Munir-Altaher/leg-day/sim/runs/parts_colour.png

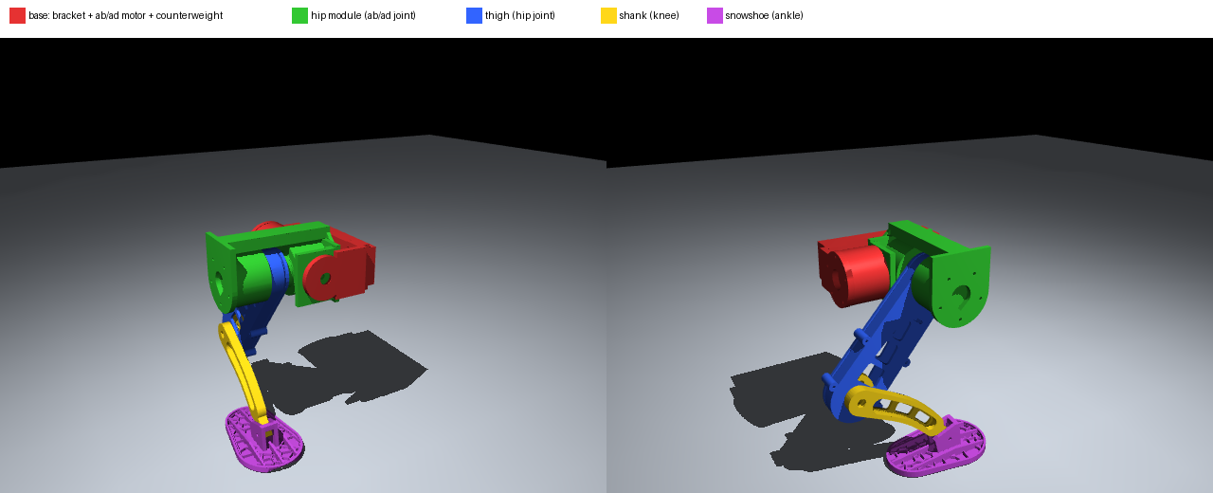
sim/runs/parts_colour.png
