Munir-Altaher/leg-day/reference/IMG_4815.jpeg

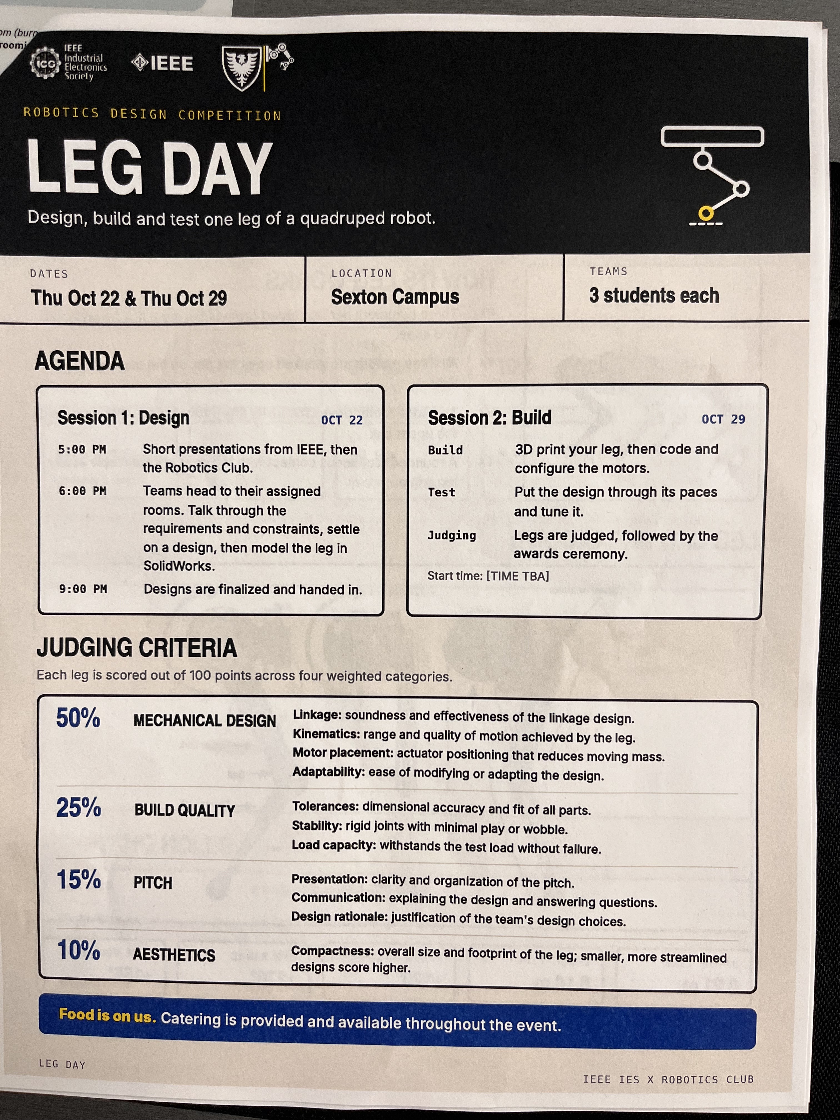
reference/IMG_4815.jpeg
