Munir-Altaher/leg-day/analysis/out/report.md

# Leg analysis report (generated by analysis/leg_model.py)

- FK->IK round trip over joint ranges: worst error 3.12e-13 deg -> PASS
- Belt-coupling virtual-work check (tau_q = A^T tau_m, th_k = q1 + N q2): PASS

## Sanity anchors (brief 4.4, 4.5)

| knee pulley | N | max vertical F (belt 120 N, rated torque) |
|---|---|---|
| 20T | 1.0 | 8.3 N |
| 40T | 2.0 | 16.6 N |
| 48T | 2.4 | 19.9 N |
| 60T | 3.0 | 24.9 N |

Ab/ad, l=40 mm, 20 N vertical: |tau0| = 0.80 Nm; with +/-2 N lateral: 0.43 / 1.17 Nm

## Design point: L1 = L2 = 130 mm, 20T:60T (N = 3.00), l = 53.0 mm

Nominal stance height STANCE_FRAC(L1+L2) = 213 mm

- Nominal stance joint angles: q1 = -34.9 deg, q2 = 69.8 deg
- Continuous capability (+/-10% lateral, motors <= rated, belt <= 60 N): **15.4 N** vertical (target >= 15 N)
- Peak capability (motors <= peak, belt <= 120 N): **30.8 N** vertical

Static load case: 15 N down + 1.5 N lateral at nominal stance
- joint torques tau_q = [0.475, 0.000, -1.116] Nm
- motor torques [abad, hip, knee] = [0.475, 0.372, -0.372] Nm (rated 1.3)
- belt effective tension = 58.4 N (continuous limit 60 N)

## Firmware limits

- knee motor torque limit = T_peak x r_hip = 120 N x 6.37 mm = **0.76 Nm**
- hip motor: 4.1 Nm peak, set 2.5 Nm (structure SF>=2, see skeleton check); ab/ad: 2.5 Nm
- knee joint torque available at belt peak: 2.29 Nm

## Belt

- open-belt length at C = 130 mm: 341.2 mm -> 342 mm (171 teeth) + idler take-up; with 2 x 15 mm clamp overlap cut 372 mm (supplied 450 mm ASSUMED)
- preload >= 60 N per span (half of peak effective tension)
- 20T hip pulley wrap ~180 deg -> ~10 teeth in mesh; idler adds wrap

## Sweep: max continuous vertical force at nominal stance (+/-10% lateral, belt 60 N, rated torque)

| L (mm) | 40T | 48T | 60T | 48T, 24T hip (N=2) | 60T, 30T hip (N=2) |
|---|---|---|---|---|---|
| 110 | 12.1 | 14.6 | 18.2 | 14.6 | 18.2 |
| 120 | 11.1 | 13.3 | 16.7 | 13.3 | 16.7 |
| 130 | 10.3 | 12.3 | 15.4 | 12.3 | 15.4 |
| 140 | 9.5 | 11.4 | 14.3 | 11.4 | 14.3 |
| 150 | 8.9 | 10.7 | 13.3 | 10.7 | 13.3 |
| 160 | 8.3 | 10.0 | 12.5 | 10.0 | 12.5 |

Belt tension depends only on the knee pulley radius; a bigger hip pulley adds teeth in mesh but lowers N.

## Ab/ad torque vs l (15 N vertical + 1.5 N lateral, nominal stance)

- l = 40 mm: |tau_abad| = 0.28 Nm
- l = 52 mm: |tau_abad| = 0.46 Nm
- l = 60 mm: |tau_abad| = 0.58 Nm
- l = 80 mm: |tau_abad| = 0.88 Nm

## Speed

- hip joint max 38.7 rad/s; knee joint (motor / N) 12.9 rad/s (rated speed)
- swing +/-60 mm in 0.2 s: I_hip ~ 22.1 kg cm^2 (extended), alpha = 55 rad/s^2, hip torque ~ 0.24 Nm
- same leg with the knee motor at the knee: I_hip ~ 53.4 kg cm^2 (2.4x)
- reflected rotor inertia: hip/abad 54 kg cm^2, knee 486 kg cm^2 (catalog 540 g cm^2 â€” if that is already output-side, divide by 100; VERIFY)
