Munir-Altaher/leg-day/analysis/out/workspace_force_side.png

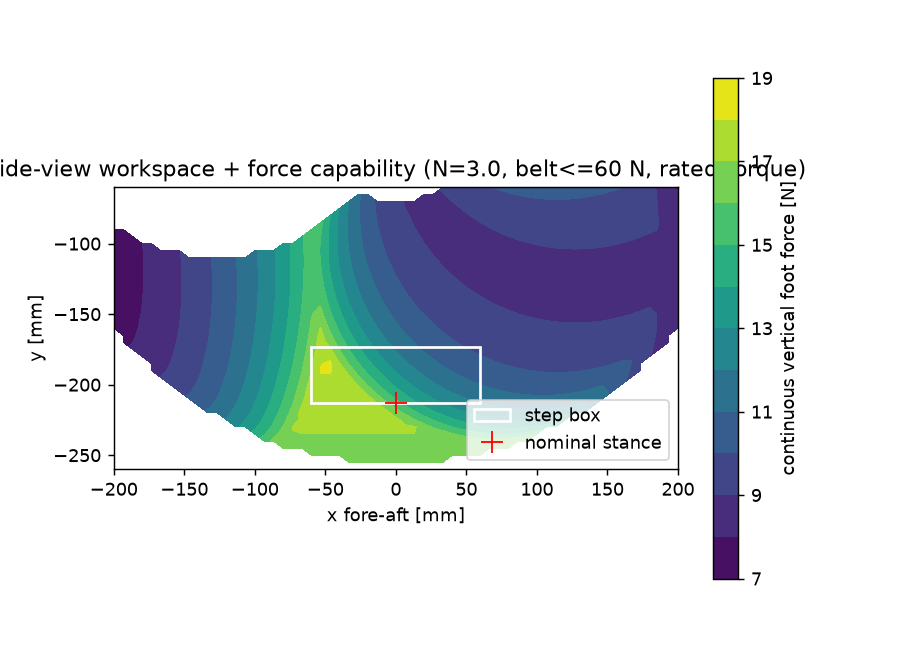
analysis/out/workspace_force_side.png
