Munir-Altaher/leg-day/analysis/out/workspace_front.png

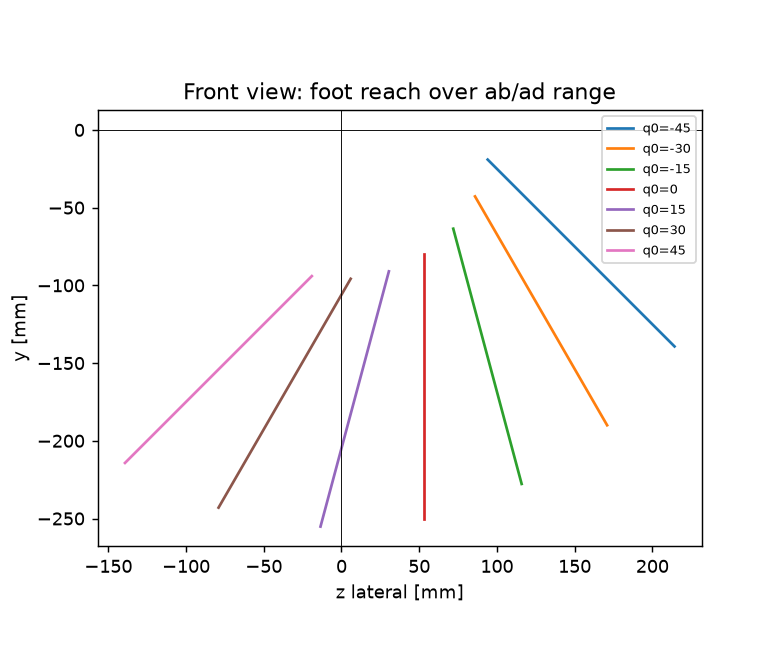
analysis/out/workspace_front.png
