Munir-Altaher/leg-day/docs/renders/bend_preview.png

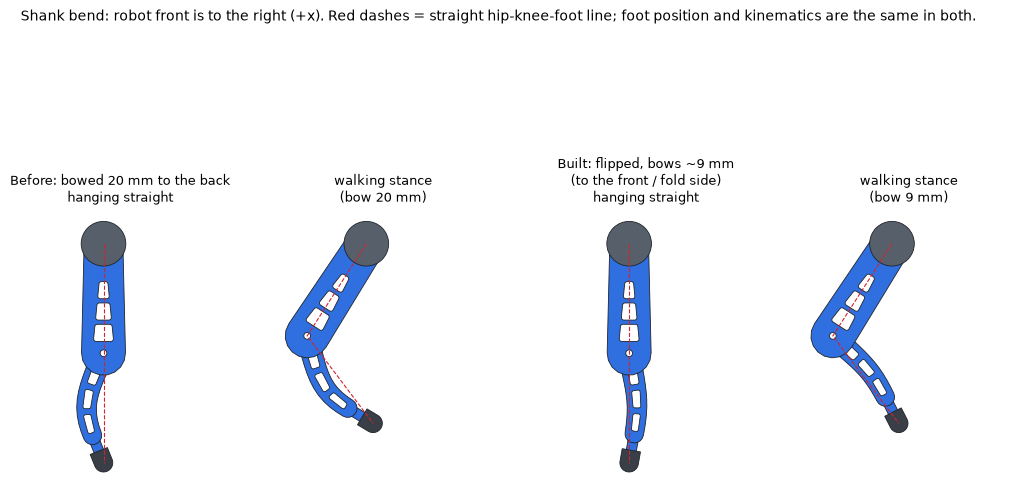
docs/renders/bend_preview.png
