Munir-Altaher/leg-day/docs/renders/cutout_final.png

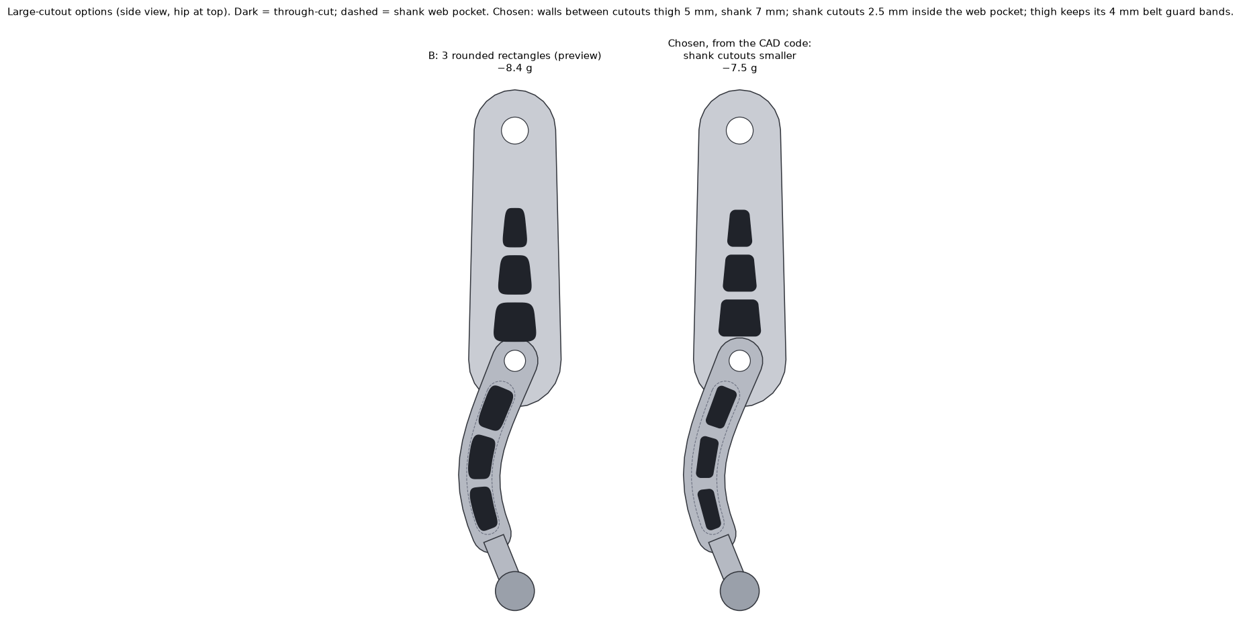
docs/renders/cutout_final.png
