Munir-Altaher/leg-day/docs/renders/cutout_options.png

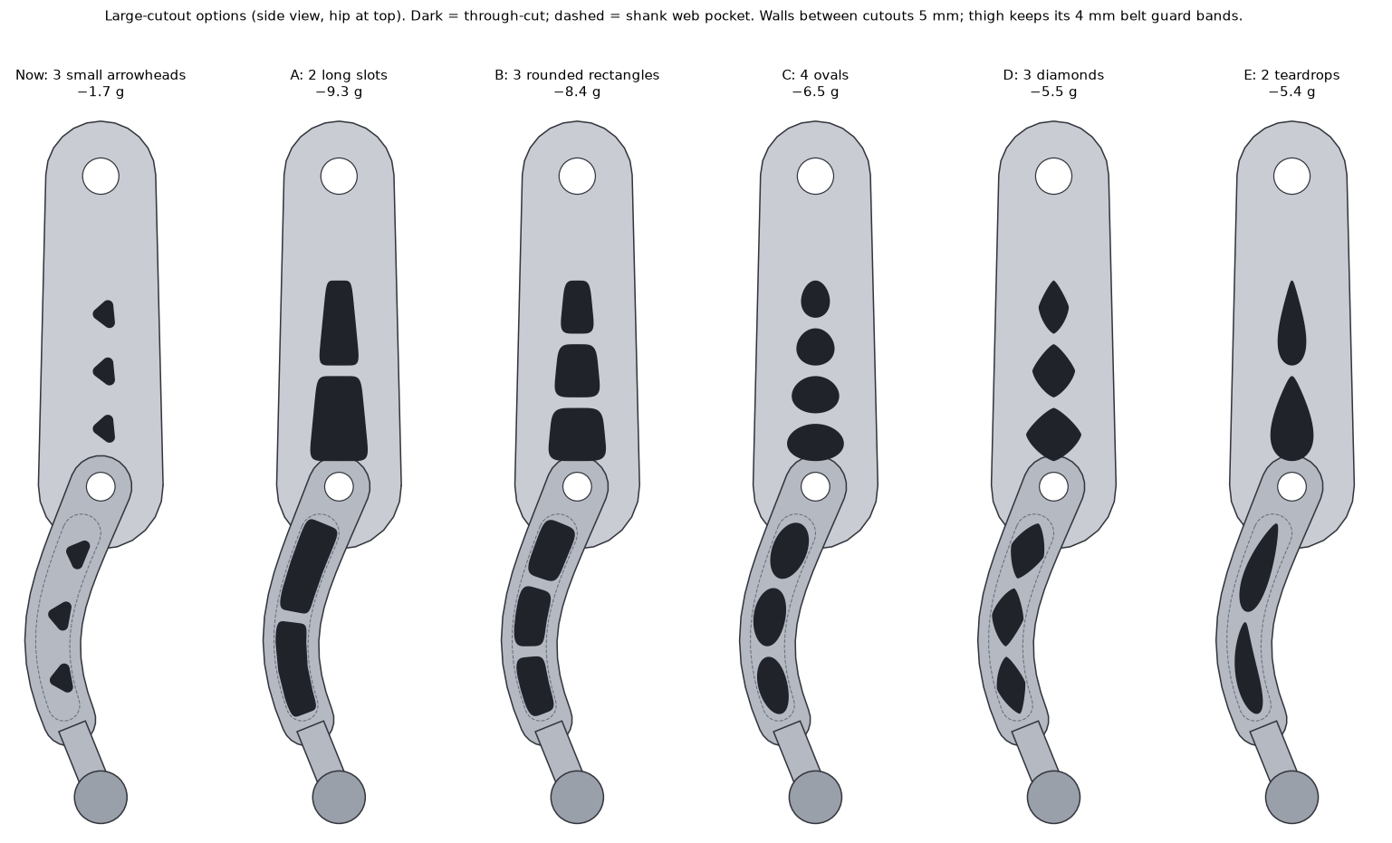
docs/renders/cutout_options.png
