Munir-Altaher/leg-day/docs/renders/cutout_options_triangles.png

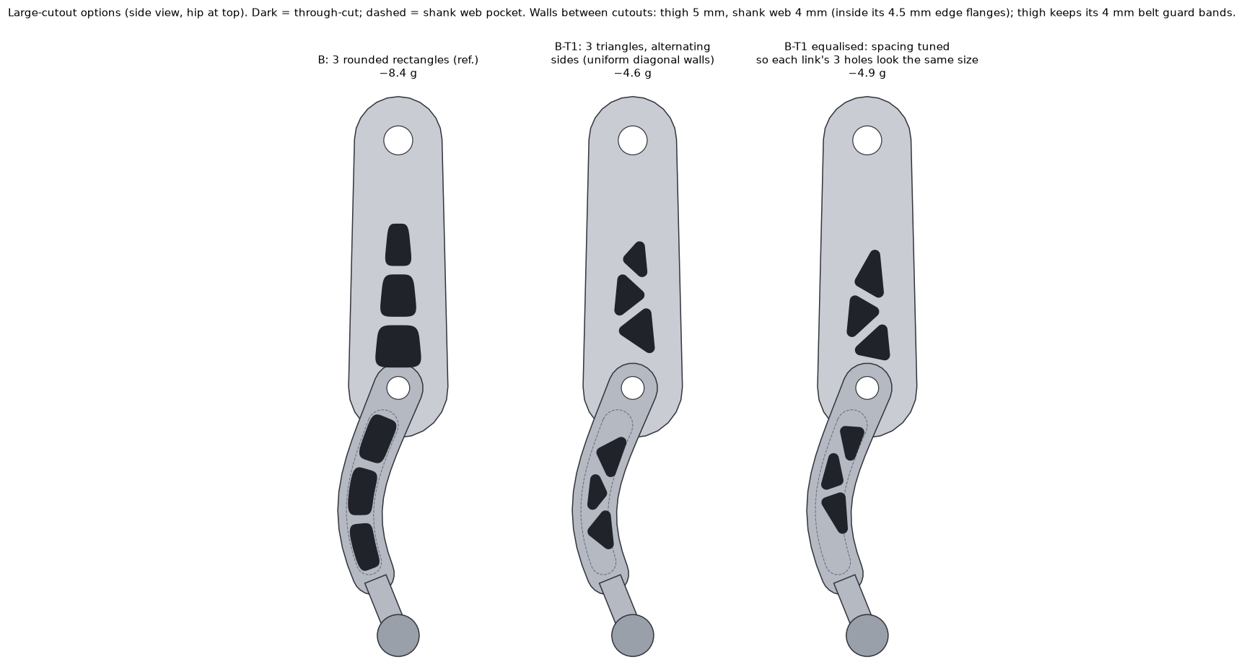
docs/renders/cutout_options_triangles.png
