Munir-Altaher/leg-day/docs/renders/leg_3dof_front.png

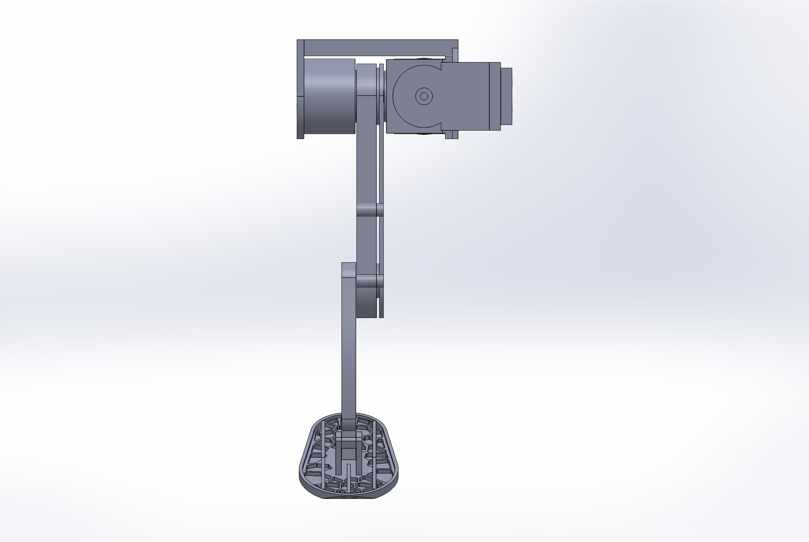
docs/renders/leg_3dof_front.png
