Munir-Altaher/leg-day/docs/renders/leg_3dof_iso.png

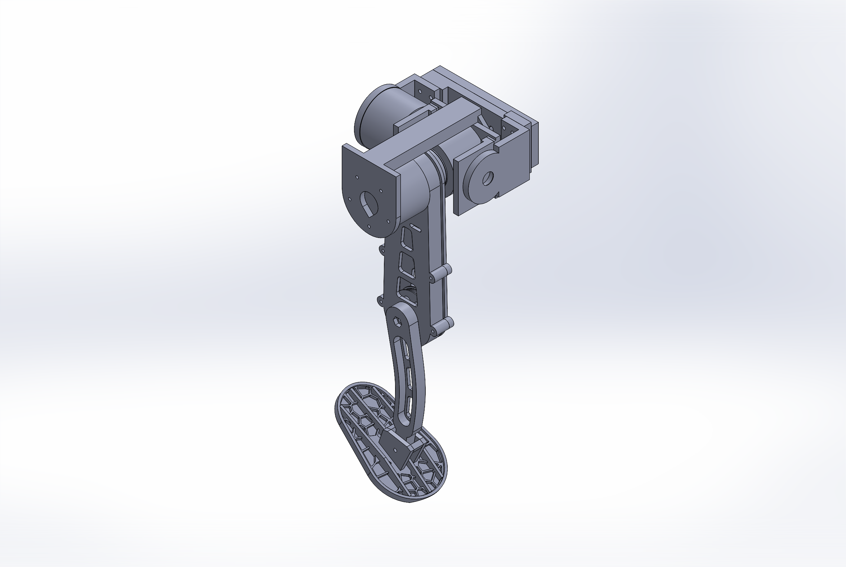
docs/renders/leg_3dof_iso.png
