Munir-Altaher/leg-day/docs/renders/leg_3dof_side.png

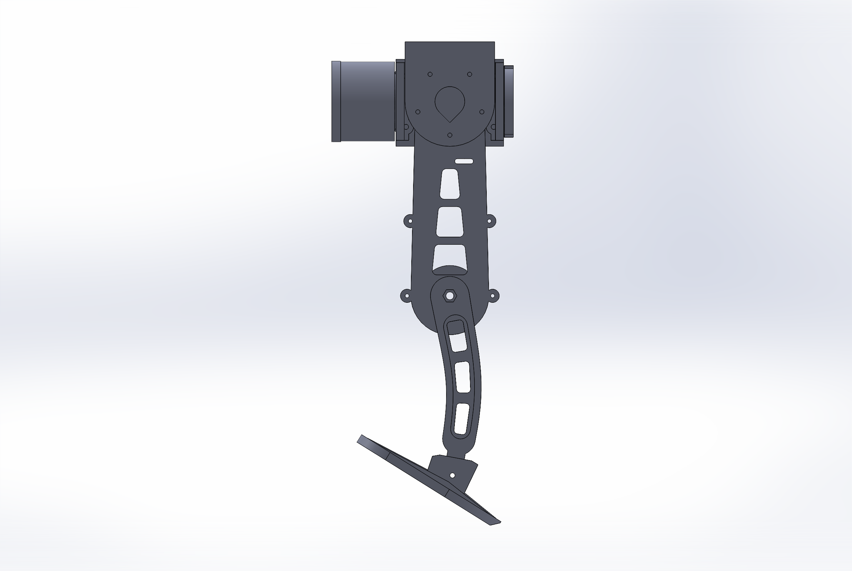
docs/renders/leg_3dof_side.png
