Munir-Altaher/leg-day/docs/renders/leg_3dof_side_outboard.png

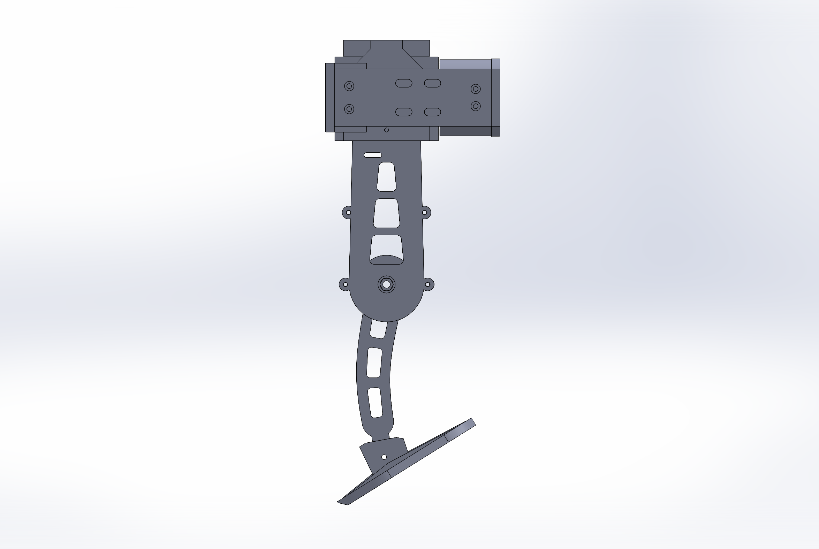
docs/renders/leg_3dof_side_outboard.png
