Munir-Altaher/leg-day/docs/renders/shank_iso.png

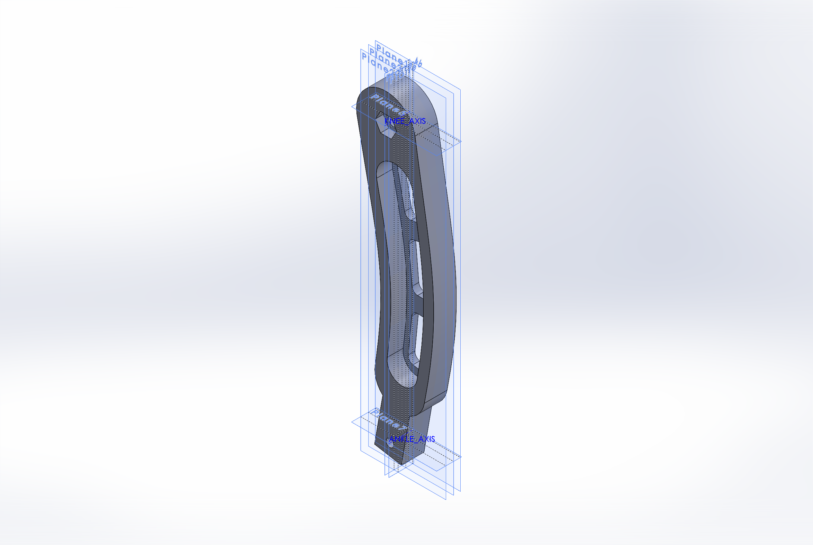
docs/renders/shank_iso.png
