Munir-Altaher/leg-day/docs/renders/snowshoe_bottom.png

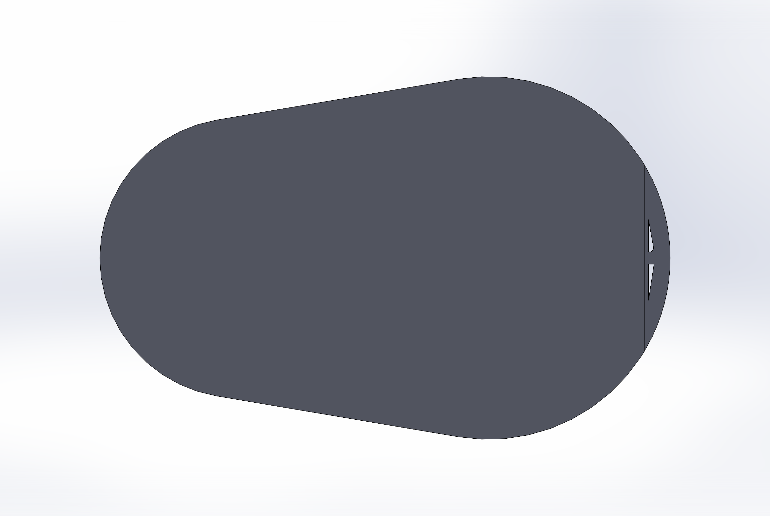
docs/renders/snowshoe_bottom.png
