Munir-Altaher/leg-day/docs/renders/snowshoe_iso.png

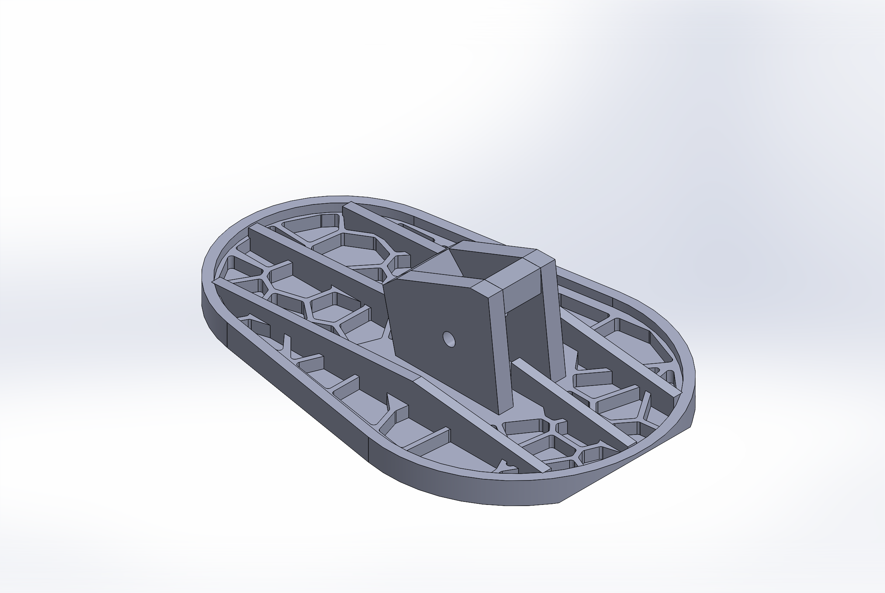
docs/renders/snowshoe_iso.png
