Munir-Altaher/leg-day/docs/renders/snowshoe_preview.png

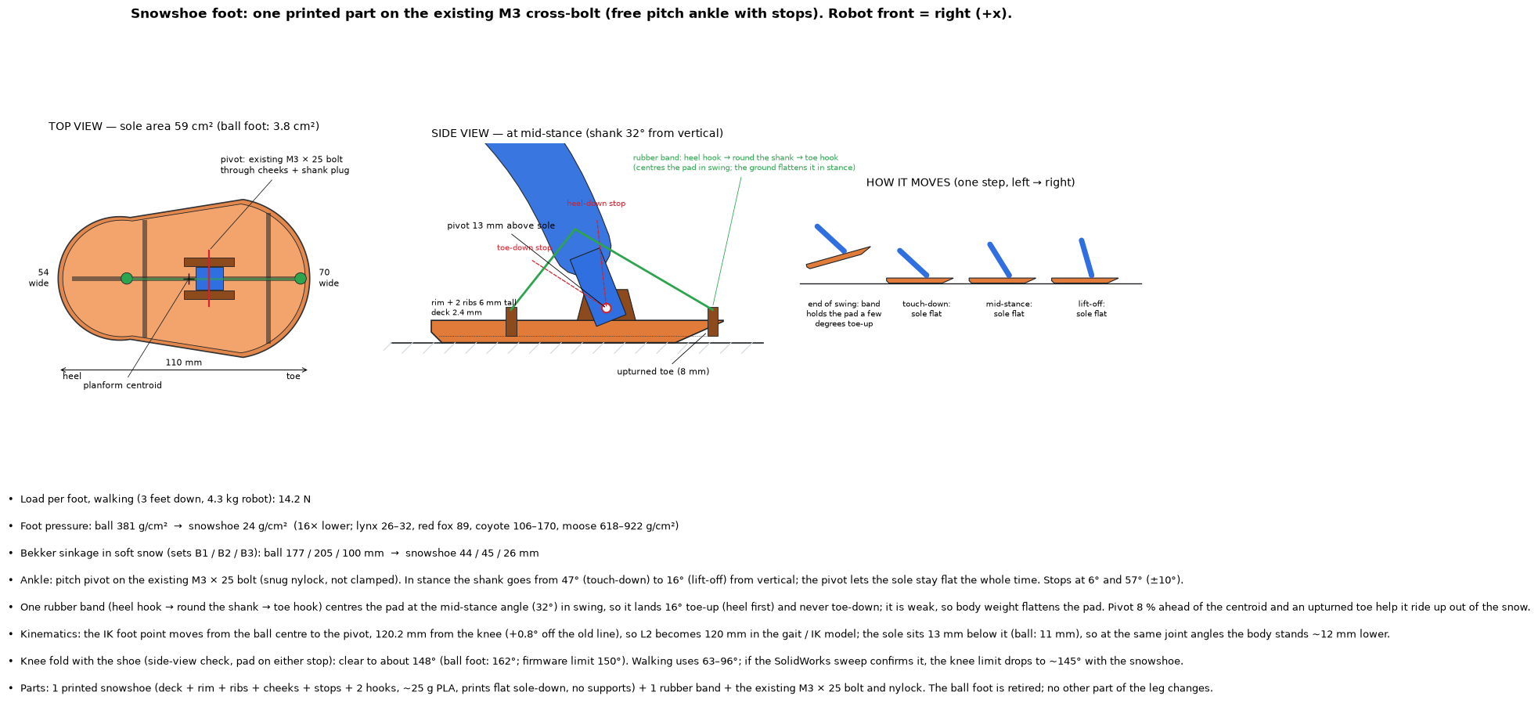
docs/renders/snowshoe_preview.png
