Munir-Altaher/leg-day/docs/renders/snowshoe_side.png

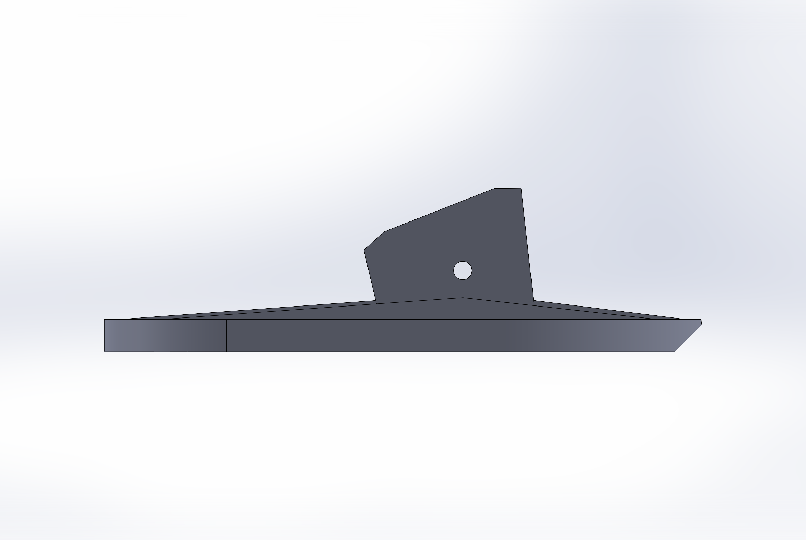
docs/renders/snowshoe_side.png
