Munir-Altaher/leg-day/docs/renders/snowshoe_top.png

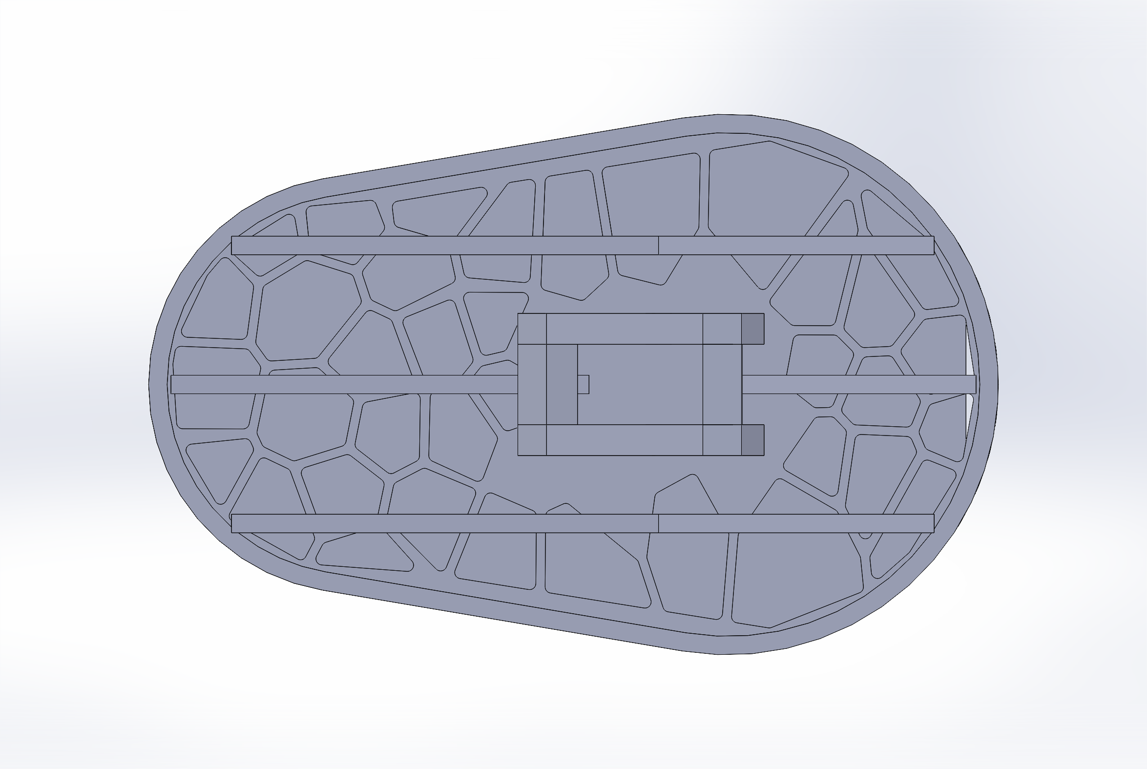
docs/renders/snowshoe_top.png
