Munir-Altaher/leg-day/docs/renders/snowshoe_v2_preview.png

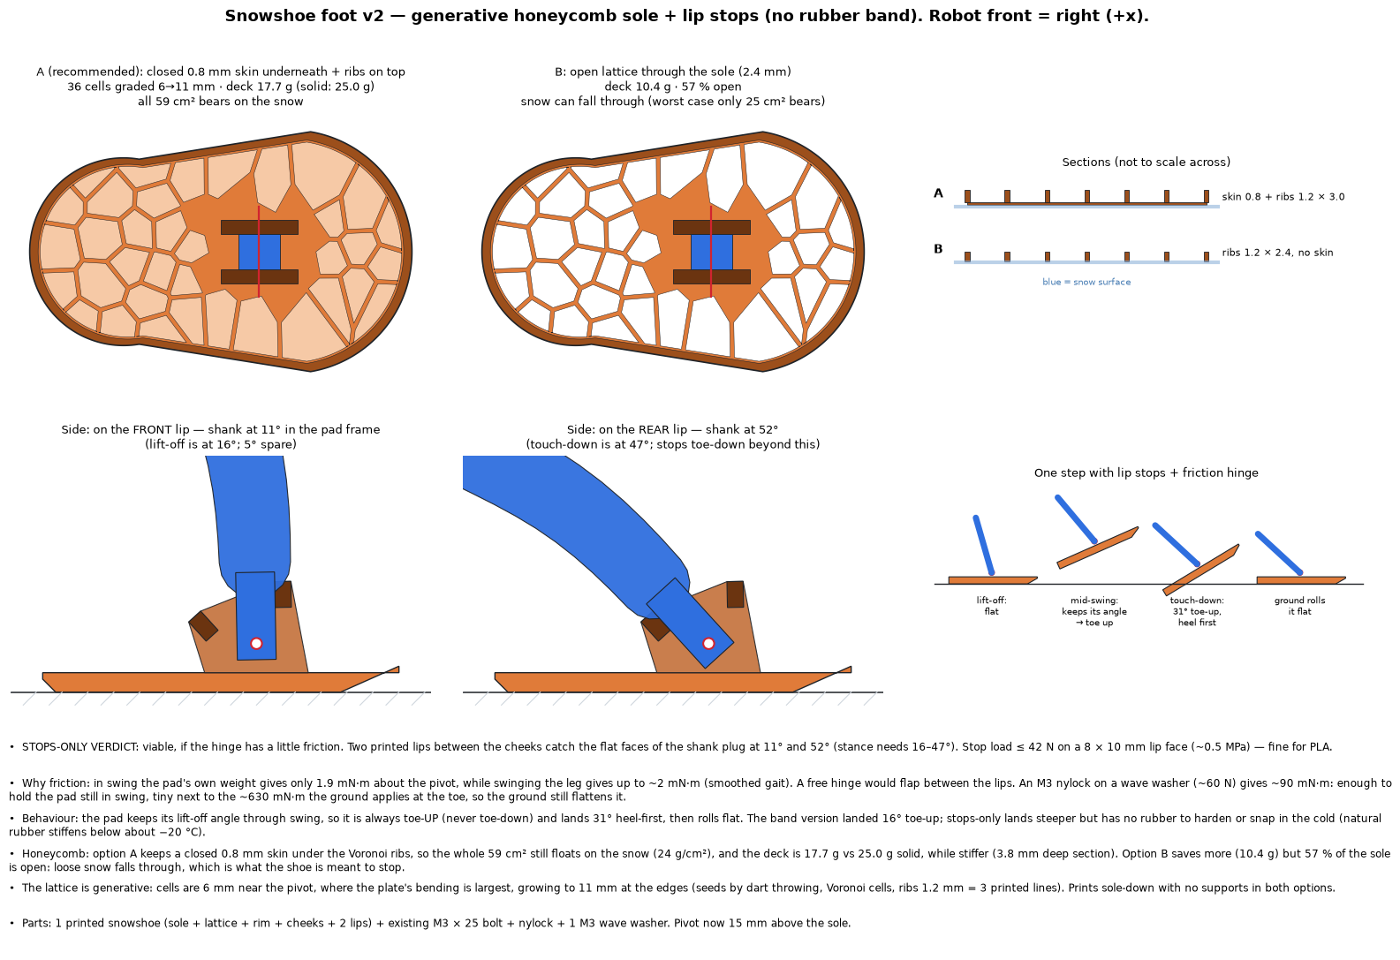
docs/renders/snowshoe_v2_preview.png
