Munir-Altaher/leg-day/docs/renders/walk_cycle.gif

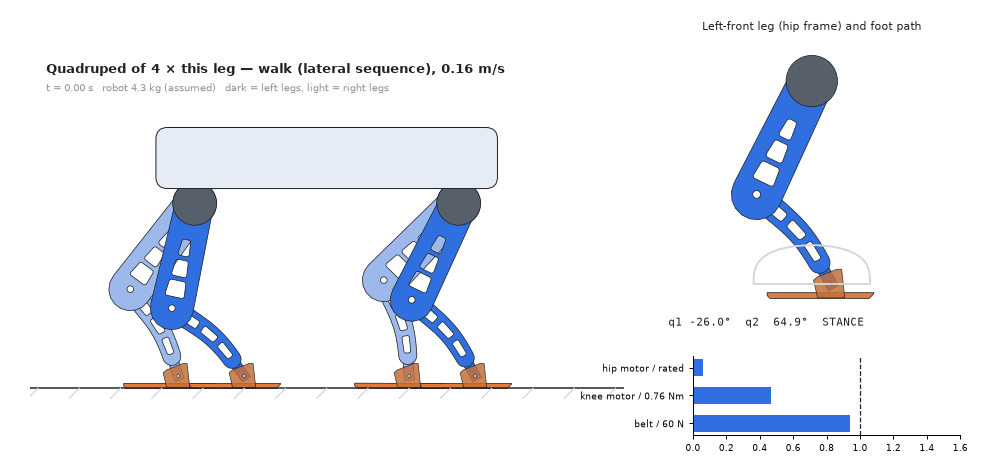
docs/renders/walk_cycle.gif
