Munir-Altaher/leg-day/docs/renders/walk_frames/f000.png

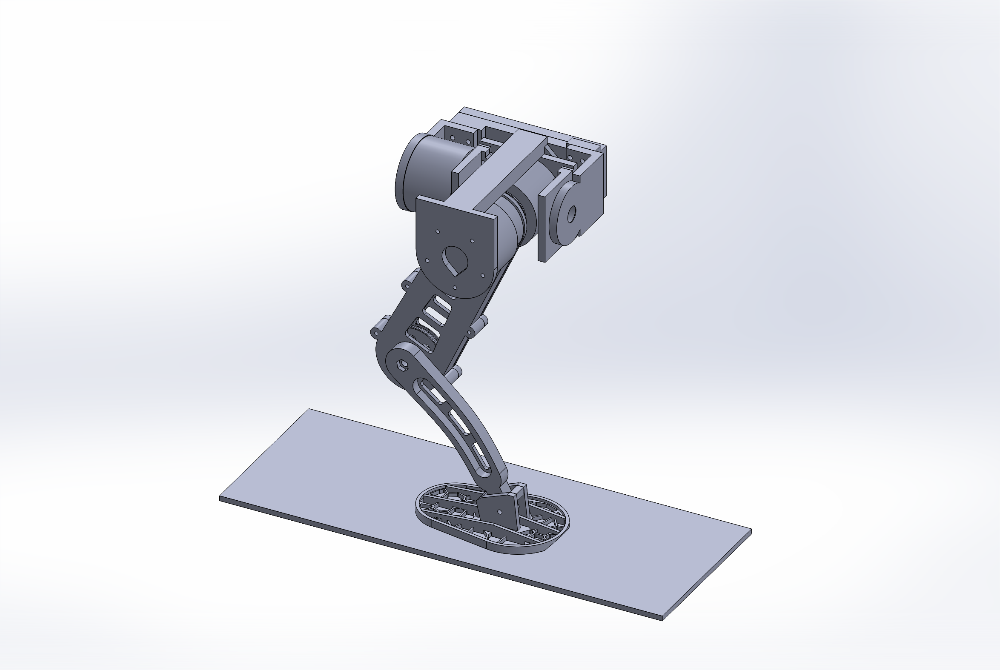
docs/renders/walk_frames/f000.png
