Munir-Altaher/leg-day/docs/renders/walk_frames/f019.png

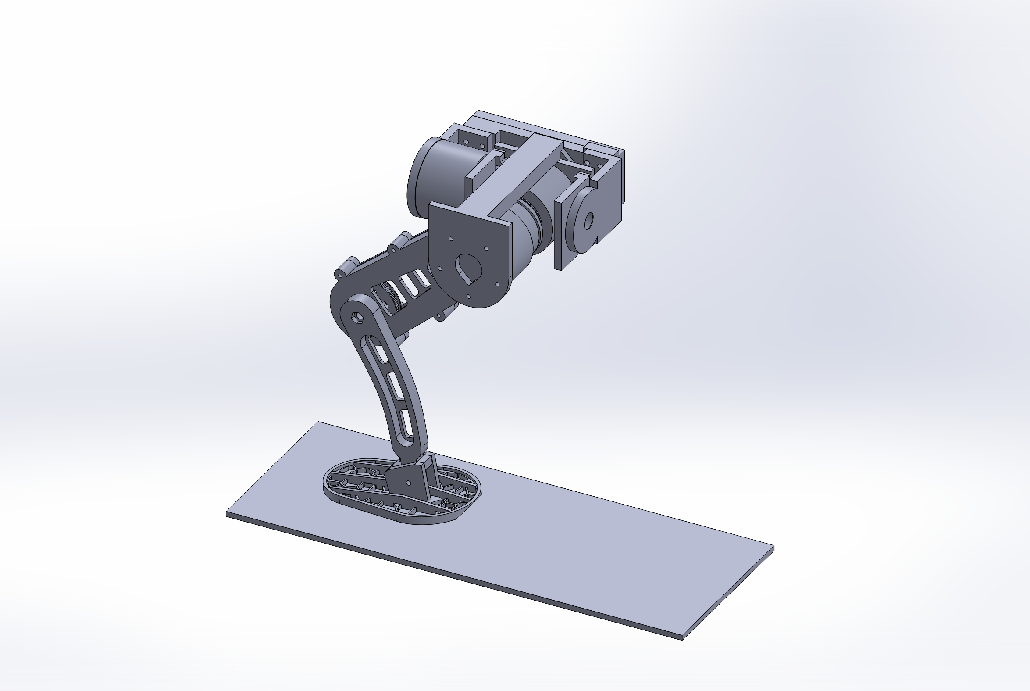
docs/renders/walk_frames/f019.png
