Munir-Altaher/leg-day/docs/renders/walk_solidworks.gif

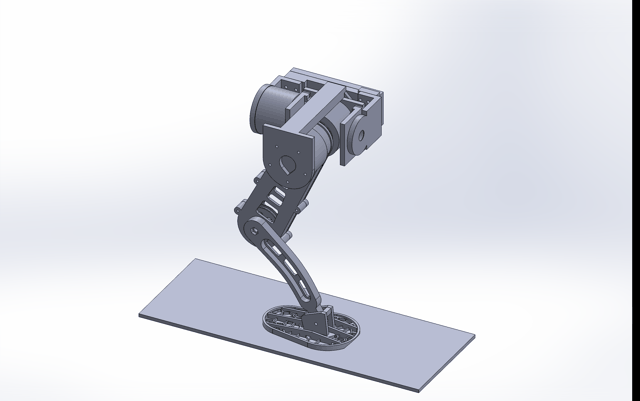
docs/renders/walk_solidworks.gif
