Munir-Altaher/leg-day/reference/IMG_4814.jpeg

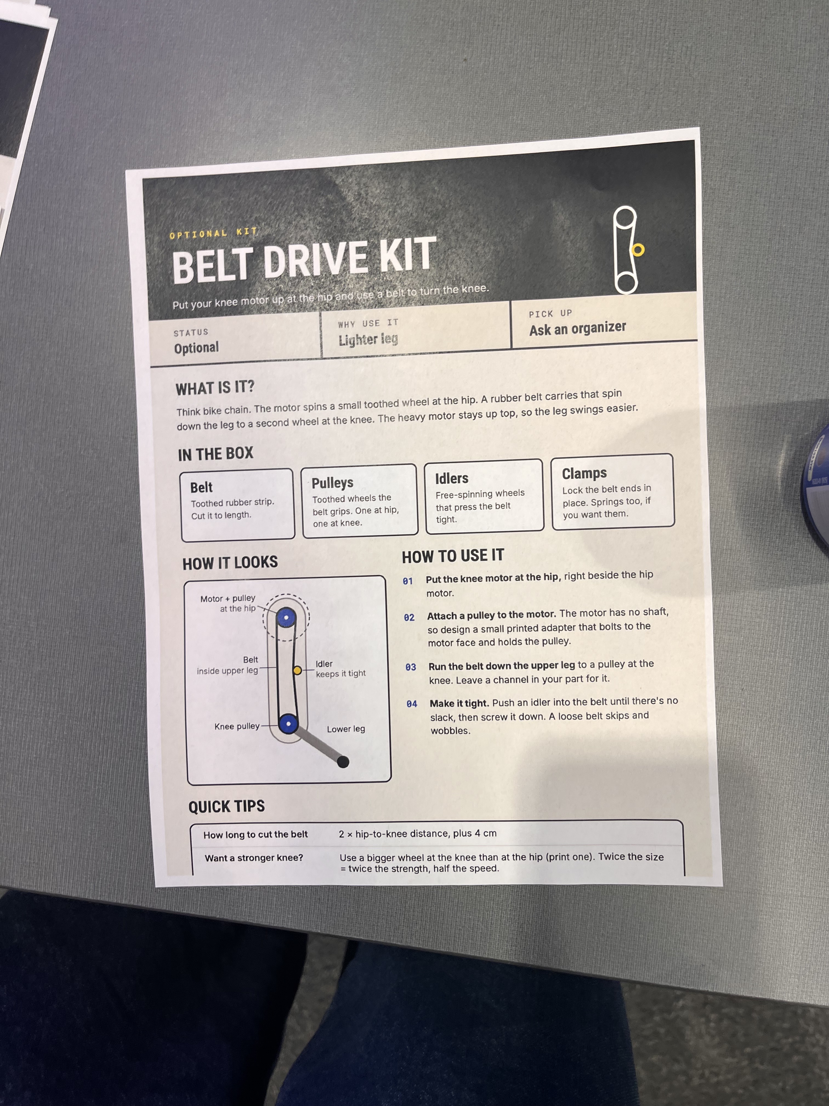
reference/IMG_4814.jpeg
