Munir-Altaher/leg-day/reference/IMG_4816.jpeg

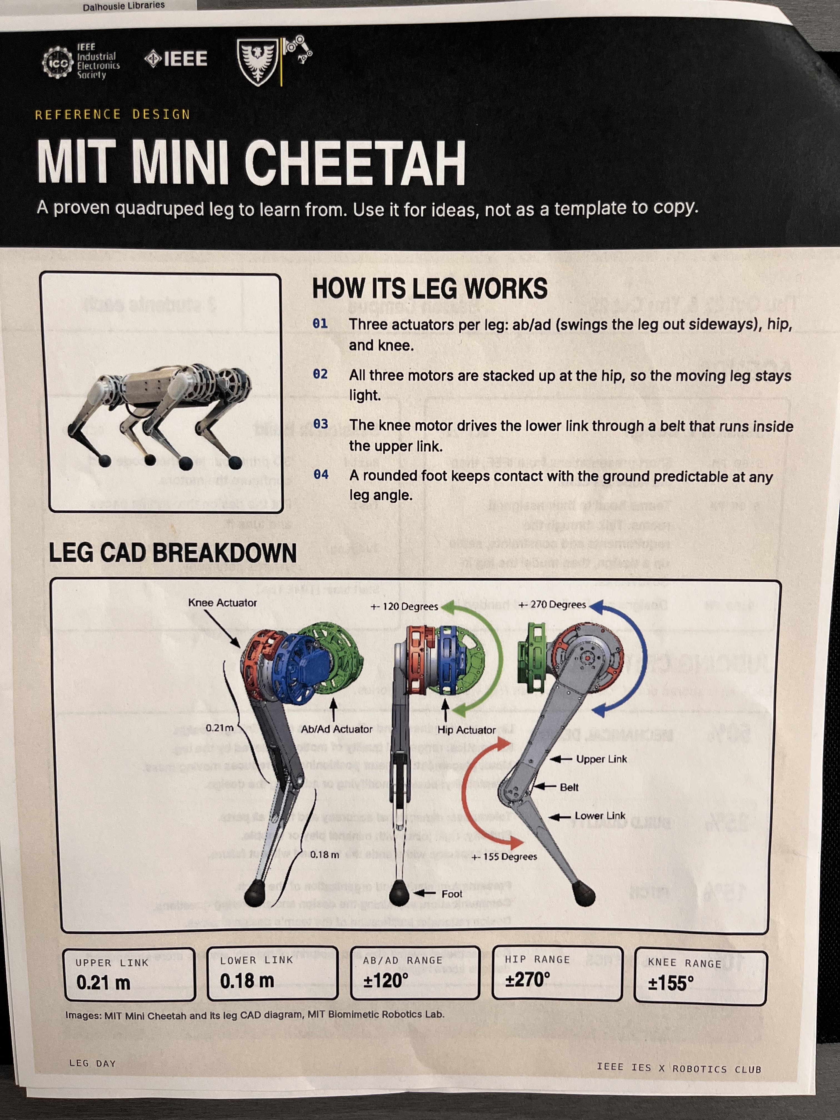
reference/IMG_4816.jpeg
