Munir-Altaher/leg-day/reference/IMG_4817.jpeg

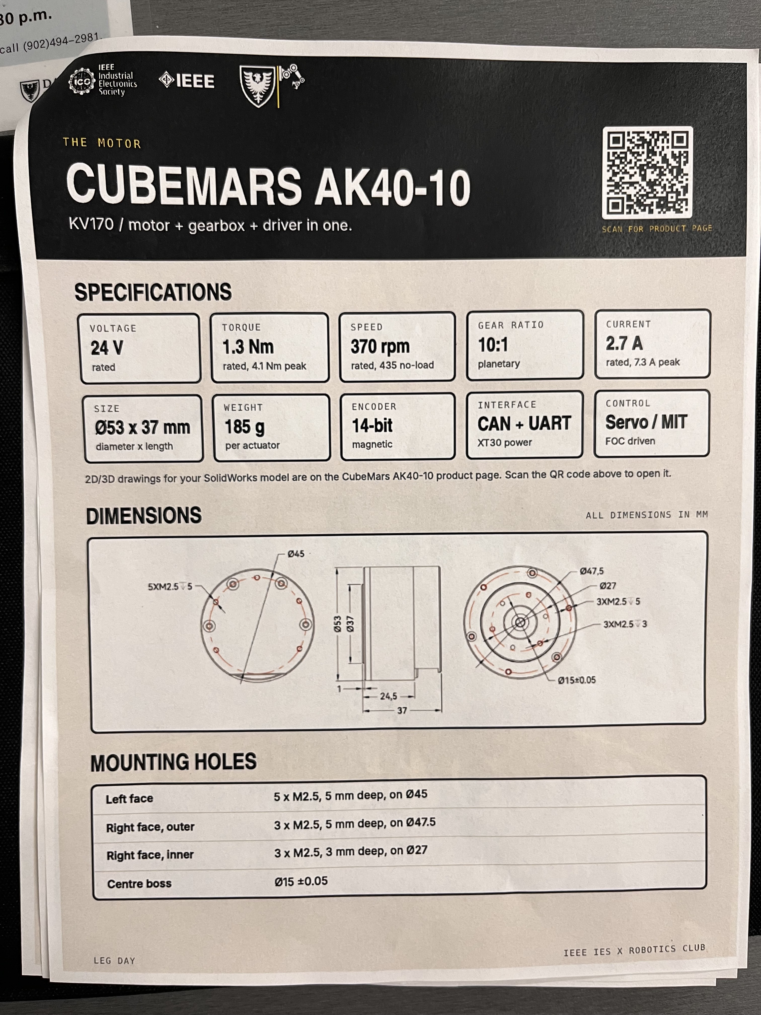
reference/IMG_4817.jpeg
