Munir-Altaher/leg-day/snow_leg/analysis/out/snow_foot_load.png

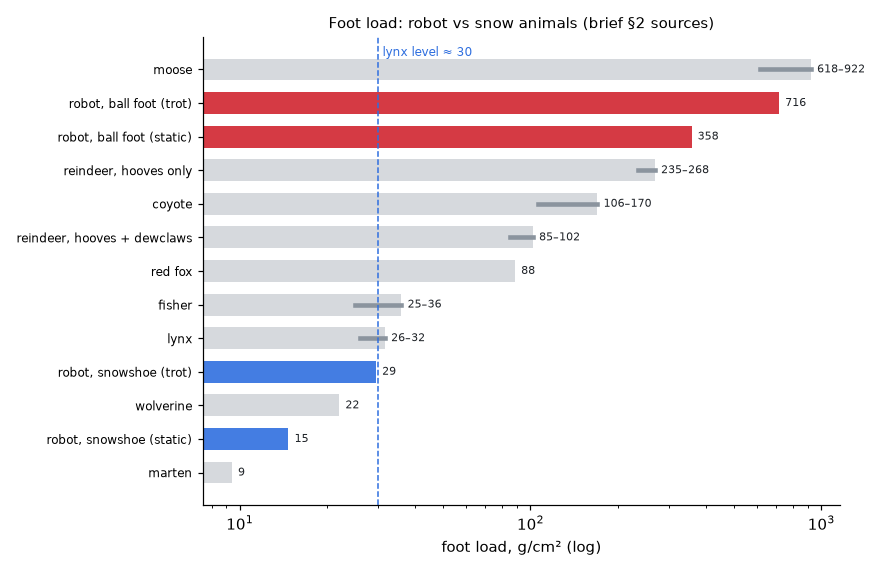
snow_leg/analysis/out/snow_foot_load.png
