Munir-Altaher/leg-day/snow_leg/analysis/out/snow_sinkage_vs_area.png

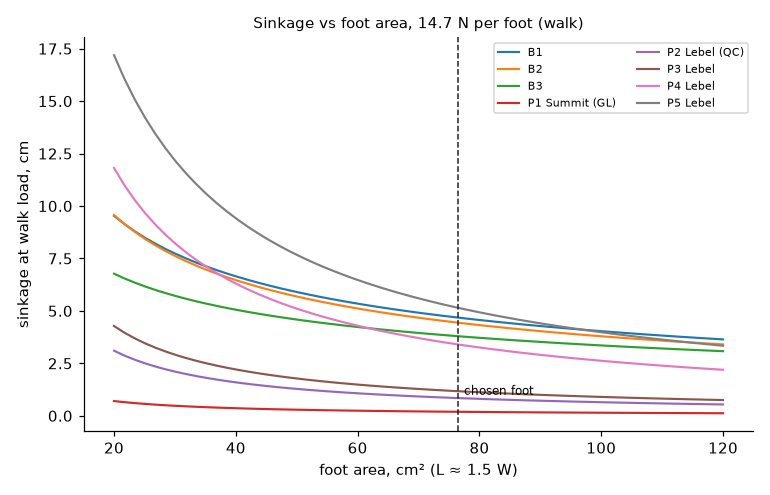
snow_leg/analysis/out/snow_sinkage_vs_area.png
