Munir-Altaher/leg-day/docs/BOM.md

# Bill of materials

Printed masses are PrusaSlicer filament grams with the profiles in `PRINT_SETTINGS.md` (`analysis/out/print.md`).

## Printed (PLA, no supports)
| Part | File | Qty | g | Notes |
|---|---|---|---|---|
| Thigh, outboard half (wall + rim) | `thigh_outer` | 1 | 48.6 | 3 rounded-rectangle cutouts; motor-boss locating hole through |
| Thigh cover | `thigh_cover` | 1 | 23.9 | 3 rounded-rectangle cutouts |
| Shank | `shank` | 1 | 18.9 | Spot-style bent channel section, 3 rounded-rectangle cutouts along the bend; tilted end plug for the foot |
| Snowshoe (pad + Voronoi ribs + keels + cheeks + lips) | `snowshoe` | 1 | 30.8 | 110 × 70 mm, closed skin underneath; prints sole-down |
| Knee pulley 60T GT2 | `knee_pulley_60T` | 1 | 7.8 | flat bed face (0.5 mm shim washer instead of the second hub spacer) |
| Hip shaft adapter | `hip_shaft_adapter` | 1 | 6.9 | 100 % infill |
| Module inboard plate | `module_plate_inboard` | 1 | 18.1 | 4 × M3 inserts for the flange feet |
| Module flange, back (ab/ad output) | `module_flange_back` | 1 | 10.2 | printed flat: holes round, no reaming |
| Module flange, front (stub axle) | `module_flange_front` | 1 | 10.4 | printed flat |
| Module C-frame (outboard plate + column + inboard tab) | `module_frame_outboard` | 1 | 54.1 | replaces the outboard plate + bridge tab |
| Body bracket, back wall | `body_bracket_back` | 1 | 18.2 | L-foot onto the spine |
| Body bracket, front wall | `body_bracket_front` | 1 | 18.3 | L-foot onto the spine |
| Body spine | `body_spine` | 1 | 31.5 | 8 mm, back block; 12 × M3 inserts |
| Rig plate | `rig_plate` | 1 | 25.4 | swappable |
| Fit-test coupon | `coupon_fit_test` | 1 | 50.1 | print first |

## Kit and bought parts
| Item | Qty | Where |
|---|---|---|
| CubeMars AK40-10 KV170 | 3 | ab/ad, hip, knee |
| GT2 6 mm belt, cut to 372 mm | 1 | thigh channel |
| GT2 20T pulley, 5 mm bore (kit) | 1 | hip shaft |
| Idler (kit, smooth, M3 bolt) | 1 | thigh slot |
| Belt clamp (kit) | 1 | belt ends |
| 625ZZ bearing (5 × 16 × 5) | 4 | thigh cover hip + knee, thigh outer knee, body front wall |

## Fasteners
| Size | Qty | Location | Thread engagement / hole depth |
|---|---|---|---|
| M3 heat-set insert (5.7 mm) | 16 | inboard plate 4, spine back block 4, spine front 4, spine underside 4 | hole Ø4.0 × 6.7 deep |
| M2.5 × 8 + M2.5 washer | 3 | thigh → hip motor rotor (Ø27) | 5.0 wall + 0.5 washer → 2.5 / 3 mm ✓ |
| M2.5 × 6 | 3 | hip shaft adapter → knee motor rotor (counterbored) | 3.5 under head → 2.5 / 3 mm ✓ |
| M2.5 × 8 | 3 | back flange → ab/ad rotor | 5.5 flange → 2.5 / 3 mm ✓ |
| M2.5 × 8 | 5 | C-frame outboard plate → hip motor back (Ø45) | 5.0 plate → 3.0 / 5 mm ✓ |
| M2.5 × 12 | 5 | C-frame tab + inboard plate → knee motor back (Ø45) | 4 + 5 → 3.0 / 5 mm ✓ |
| M2.5 × 8 | 5 | back wall → ab/ad motor back (Ø45) | 6.0 wall → 2.0 / 5 mm ✓ |
| M5 × 16 | 1 | hip shaft (head in the adapter) | ends 0.6 mm short of the hip motor face (through-hole in the thigh) |
| M5 × 25, partially threaded | 2 | knee axle (head in the shank), ab/ad stub axle | steel axles |
| M5 nylock | 1 | knee pulley hex pocket (threadlocker) | |
| M5 washer 1 mm + M5 shim 0.5 mm | 1 + 1 | shank ↔ knee bearing; knee pulley ↔ outer-wall bearing | |
| M3 × 12 + washer | 4 + 4 + 4 | flange feet → plate; back wall foot → spine; front wall foot → spine | 6 mm in the insert |
| M3 × 10 | 4 | rig plate → spine (heads in counterbores) | 5.5 mm in the insert |
| M3 × 16 | 3 | thigh cover → hip bosses (self-tap Ø2.6) | ~8 mm |
| M3 × 20 | 4 | thigh cover → ears (self-tap Ø2.6) | ~10 mm |
| M3 × 25 + M3 nylock + M3 wave washer | 1 + 1 + 1 | ankle pivot: cheek – shank plug – cheek (friction hinge) | |
| M3 × 16 + nut | 1 | idler | |
| M5 × 12 + T-nuts | 4 | rig plate → test rig (20 mm grid slots) | |
