Munir-Altaher/leg-day/cad/parts/snowshoe.STEP

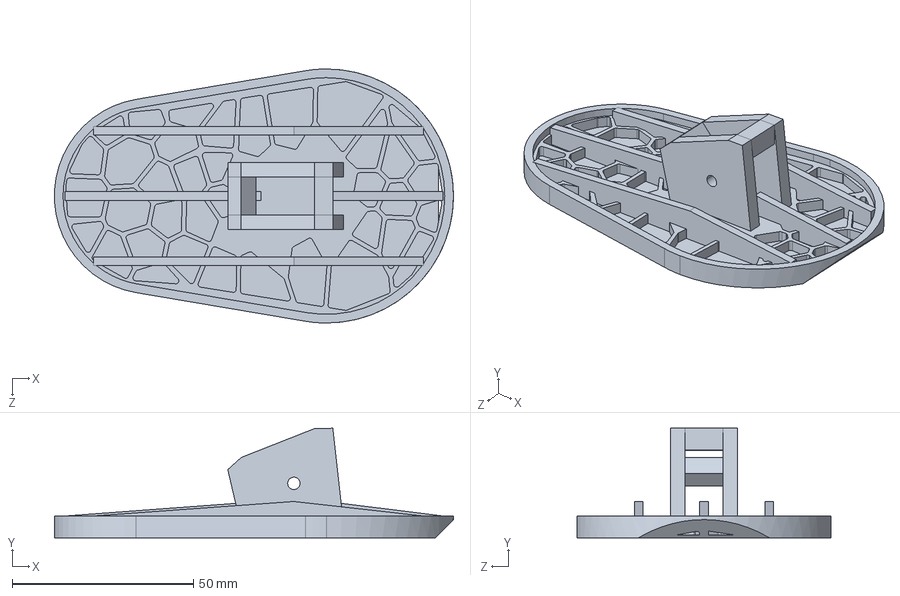
[picture p29: CAD file, 2026-10-24]
cad/parts/snowshoe.STEP
109.9 x 30.2 x 70.0 mm
