Munir-Altaher/leg-day/sim/meshes/shoe.stl

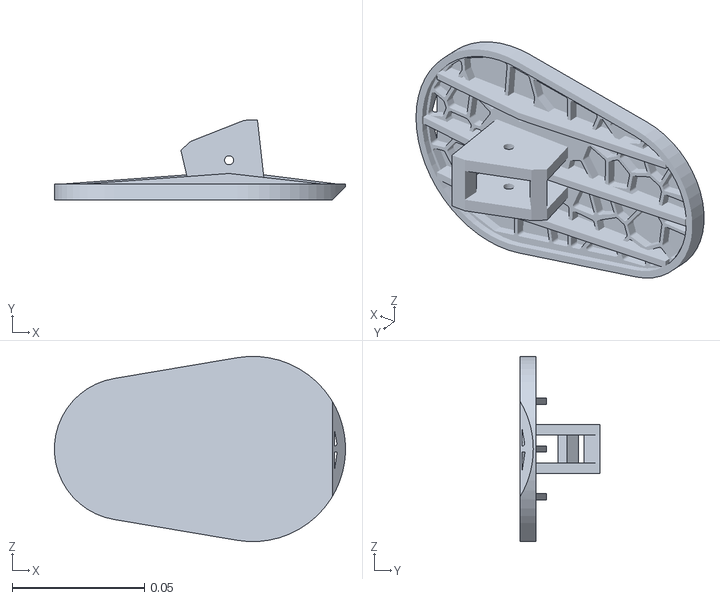
[picture p30: CAD file, 2026-10-24]
sim/meshes/shoe.stl
0.11 x 0.0302 x 0.0699
