Munir-Altaher/leg-day/snow_leg/cad/parts/snow_foot_snowshoe.STEP

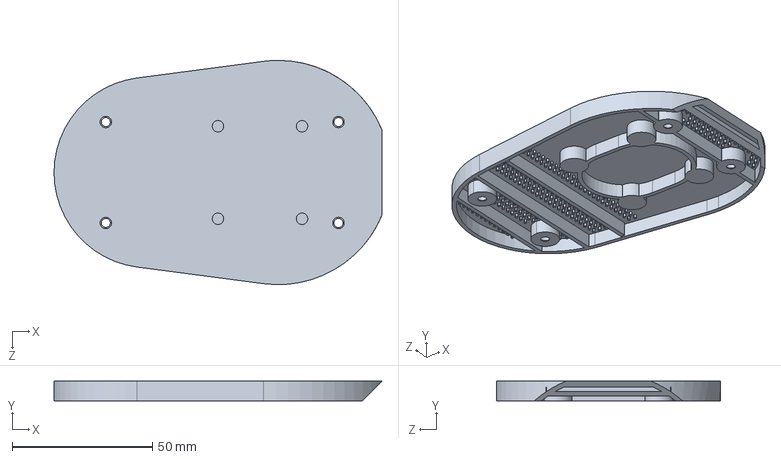
[picture p31: CAD file, 2026-10-24]
snow_leg/cad/parts/snow_foot_snowshoe.STEP
117.0 x 7.00 x 80.0 mm
