Munir-Altaher/leg-day/snow_leg/cad/stl/assembly_pose/snow_module_flange_front.STL

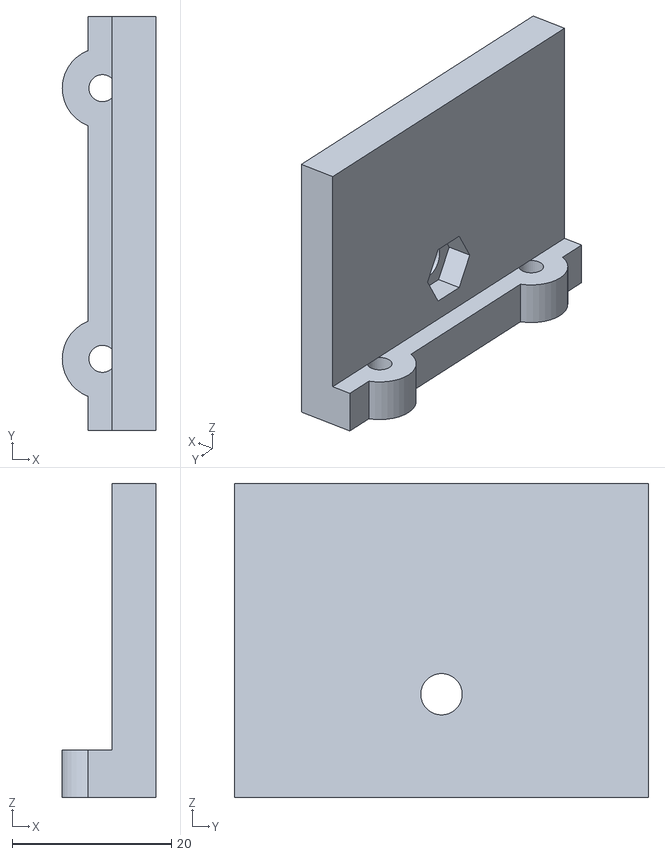
[picture p32: CAD file, 2026-10-24]
snow_leg/cad/stl/assembly_pose/snow_module_flange_front.STL
11.8 x 52.0 x 39.5
