Munir-Altaher/leg-day/snow_leg/docs/verification/original_print/thigh_cover.stl

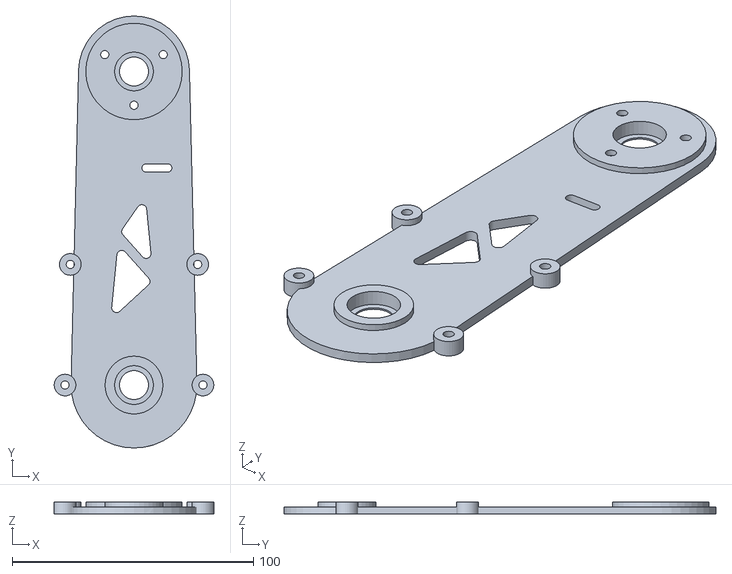
[picture p33: CAD file, 2026-10-24]
snow_leg/docs/verification/original_print/thigh_cover.stl
66.2 x 179.1 x 5.00
