Munir-Altaher/leg-day/cad/parts/ref_motor_hip.STEP

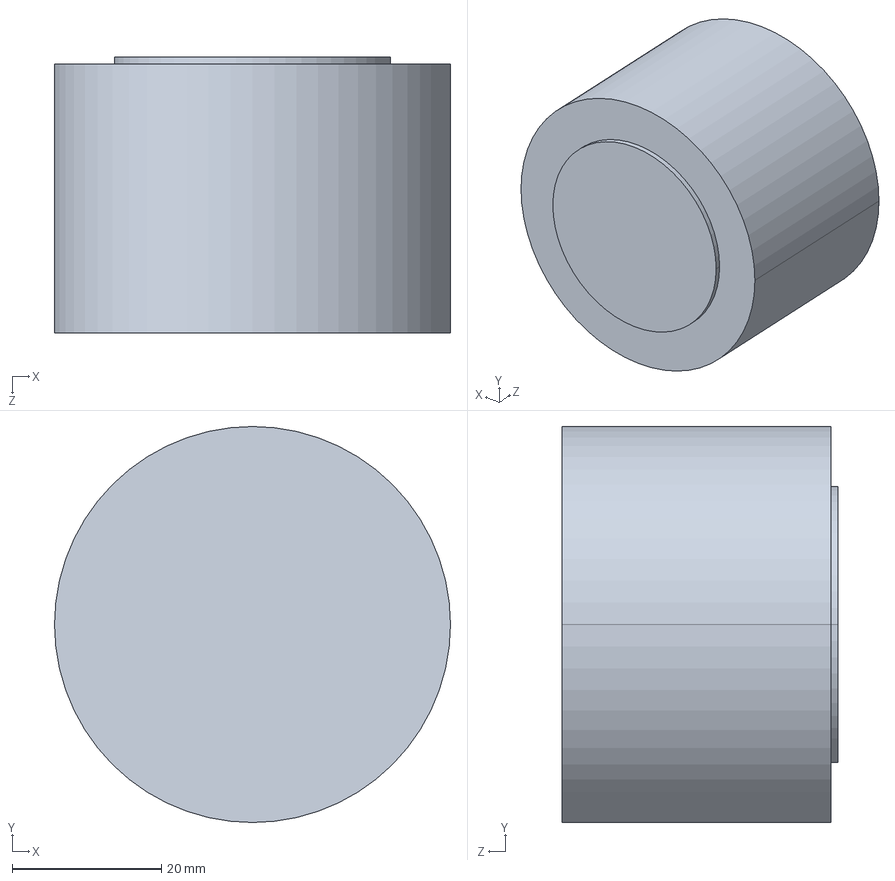
[picture p34: CAD file, 2026-10-24]
cad/parts/ref_motor_hip.STEP
53.0 x 53.0 x 37.0 mm
