Munir-Altaher/leg-day/sim/meshes/shank.stl

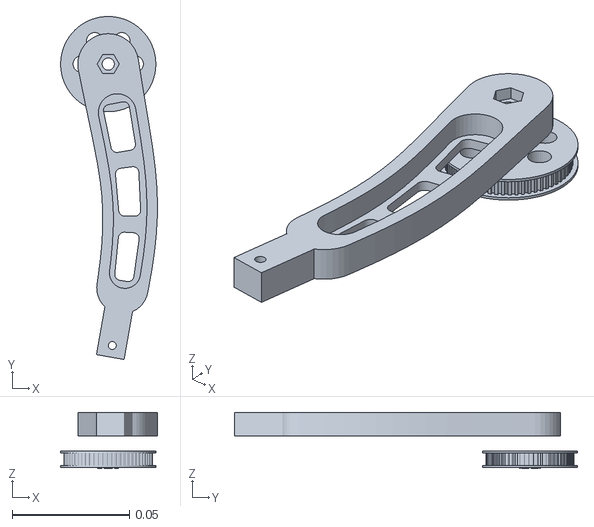
[picture p35: CAD file, 2026-10-24]
sim/meshes/shank.stl
0.0413 x 0.146 x 0.024
