Munir-Altaher/leg-day/snow_leg/cad/parts/snow_module_flange_back.STEP

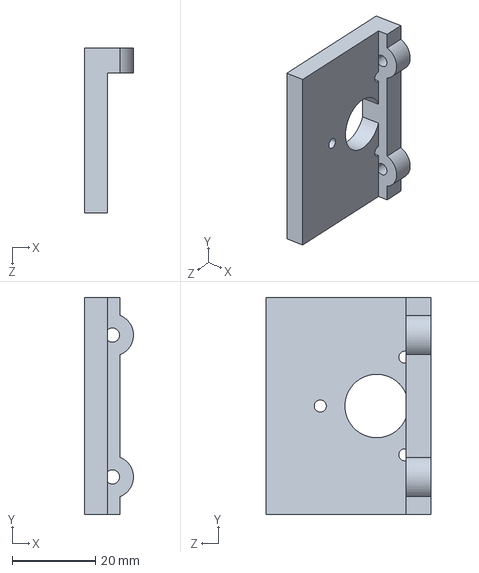
[picture p36: CAD file, 2026-10-24]
snow_leg/cad/parts/snow_module_flange_back.STEP
11.8 x 52.0 x 39.5 mm
