Munir-Altaher/leg-day/snow_leg/docs/verification/original_print/knee_pulley_60T.stl

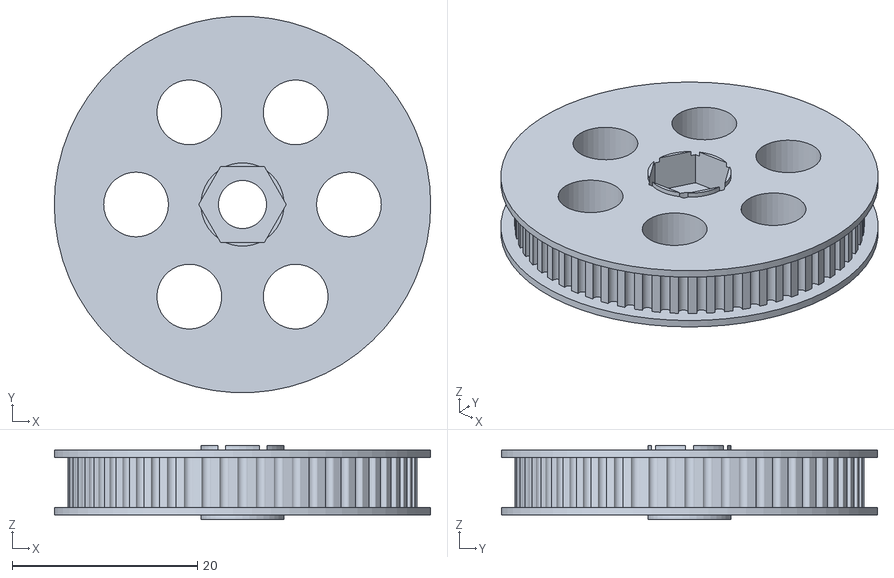
[picture p37: CAD file, 2026-10-24]
snow_leg/docs/verification/original_print/knee_pulley_60T.stl
40.7 x 40.6 x 8.00
