Munir-Altaher/leg-day/cad/parts/module_frame_outboard.STEP

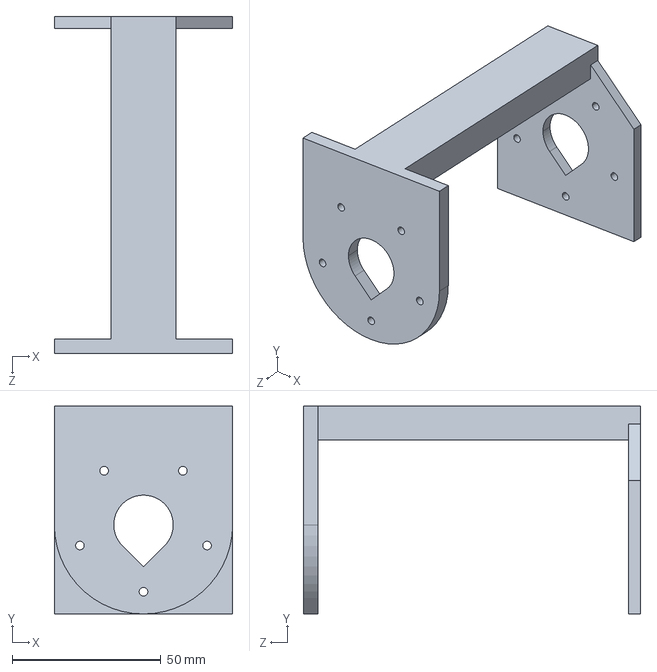
[picture p38: CAD file, 2026-10-24]
cad/parts/module_frame_outboard.STEP
60.0 x 70.0 x 113.5 mm
