Munir-Altaher/leg-day/sim/meshes/abad.stl

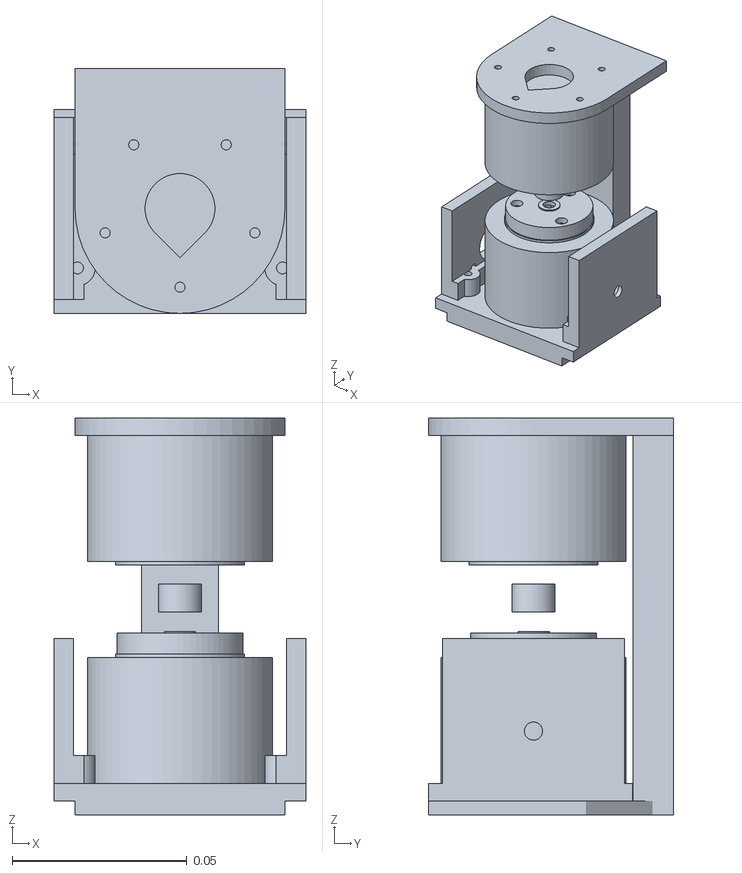
[picture p39: CAD file, 2026-10-24]
sim/meshes/abad.stl
0.072 x 0.07 x 0.114
