Munir-Altaher/leg-day/snow_leg/cad/parts/snow_rig_plate.STEP

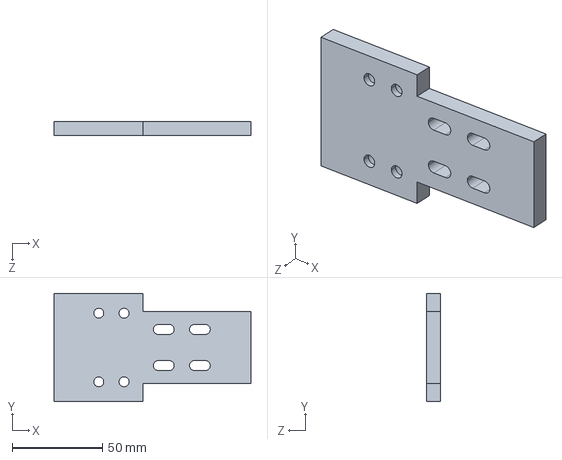
[picture p40: CAD file, 2026-10-24]
snow_leg/cad/parts/snow_rig_plate.STEP
109.1 x 60.0 x 8.00 mm
