Munir-Altaher/leg-day/snow_leg/cad/stl/assembly_pose/snow_ref_ground.STL

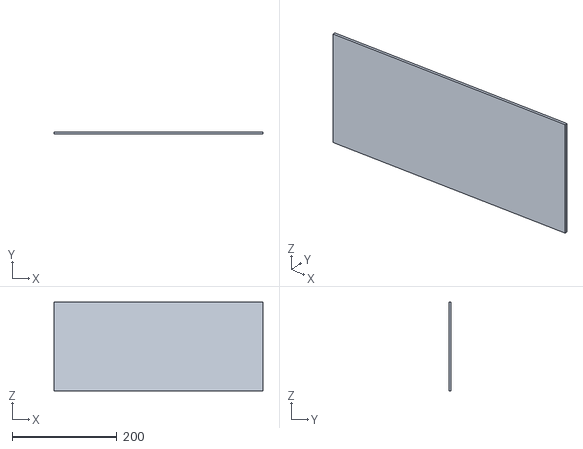
[picture p41: CAD file, 2026-10-24]
snow_leg/cad/stl/assembly_pose/snow_ref_ground.STL
400.0 x 4.00 x 170.0
