Munir-Altaher/leg-day/snow_leg/docs/verification/original_print/body_spine.stl

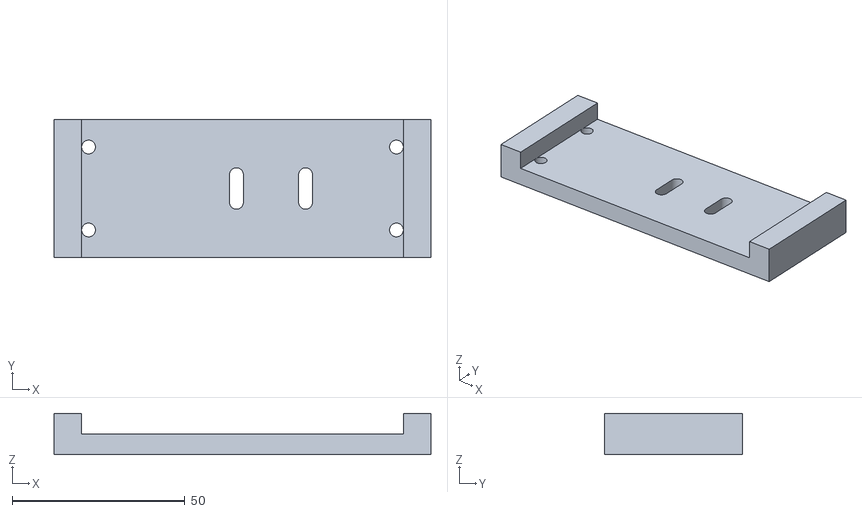
[picture p42: CAD file, 2026-10-24]
snow_leg/docs/verification/original_print/body_spine.stl
109.1 x 40.0 x 12.0
