Munir-Altaher/leg-day/sim/meshes/base.stl

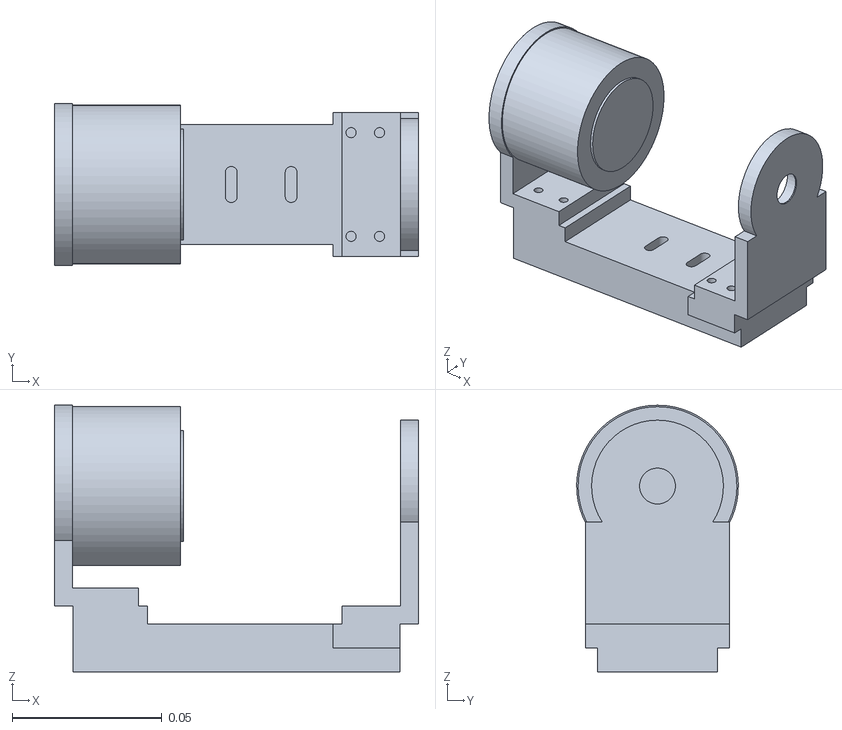
[picture p43: CAD file, 2026-10-24]
sim/meshes/base.stl
0.122 x 0.054 x 0.089
