Munir-Altaher/leg-day/snow_leg/cad/parts/snow_ankle_bracket_out.STEP

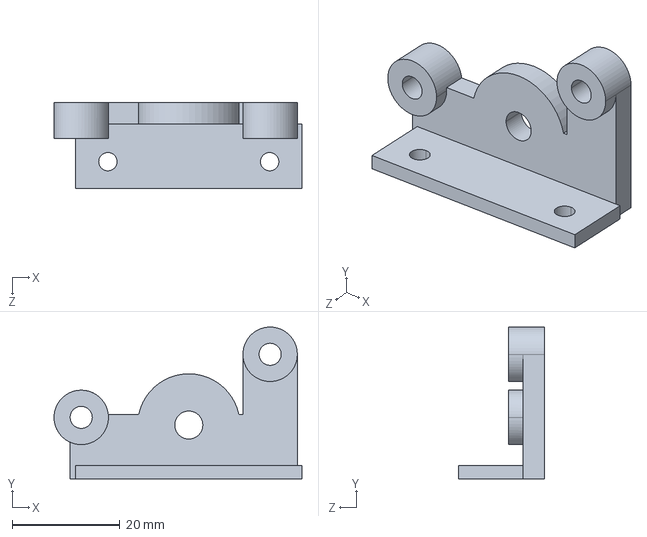
[picture p44: CAD file, 2026-10-24]
snow_leg/cad/parts/snow_ankle_bracket_out.STEP
46.0 x 28.2 x 16.0 mm
