Munir-Altaher/leg-day/snow_leg/docs/verification/original_print/body_bracket_front.stl

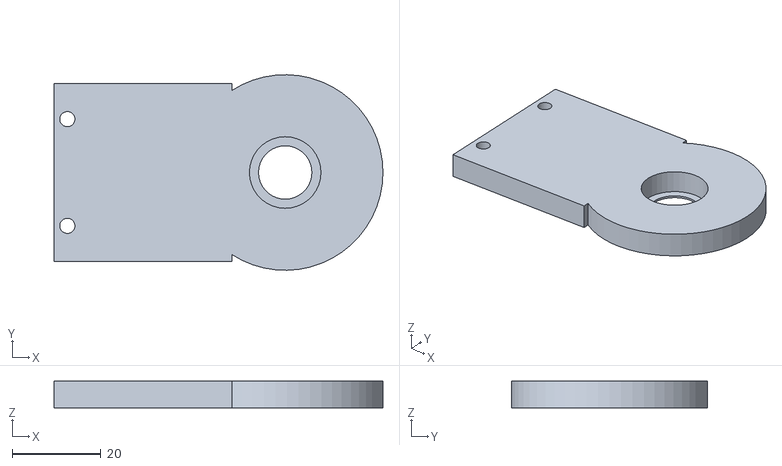
[picture p45: CAD file, 2026-10-24]
snow_leg/docs/verification/original_print/body_bracket_front.stl
74.0 x 44.0 x 6.00
