Munir-Altaher/leg-day/cad/parts/hip_shaft_adapter.STEP

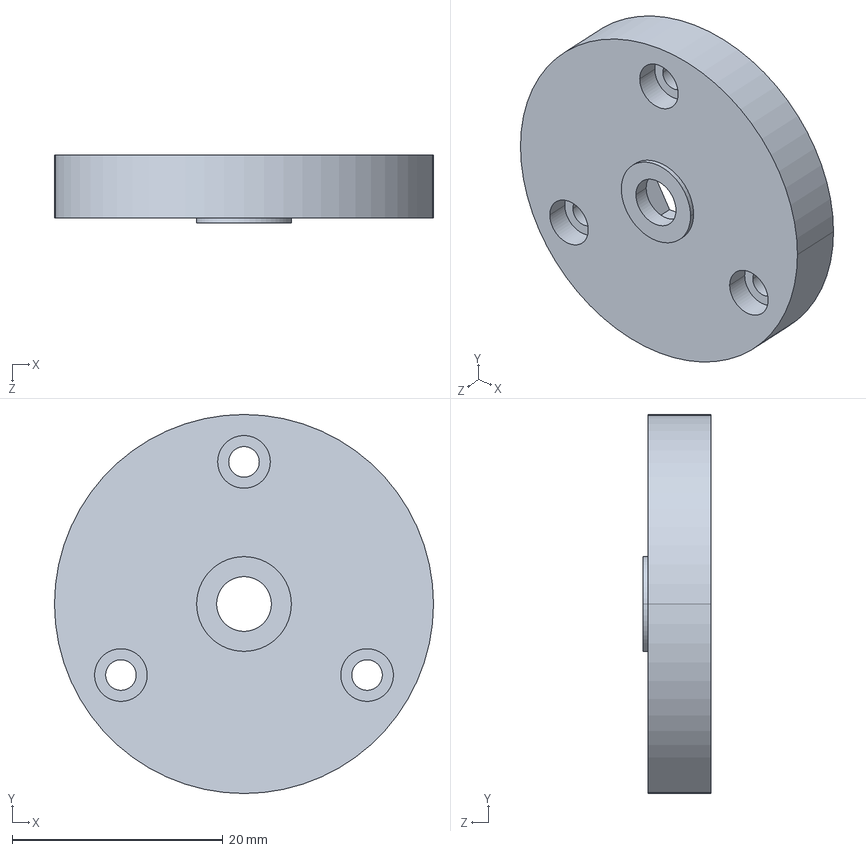
[picture p46: CAD file, 2026-10-24]
cad/parts/hip_shaft_adapter.STEP
36.0 x 36.0 x 6.50 mm
