Munir-Altaher/leg-day/sim/meshes/thigh.stl

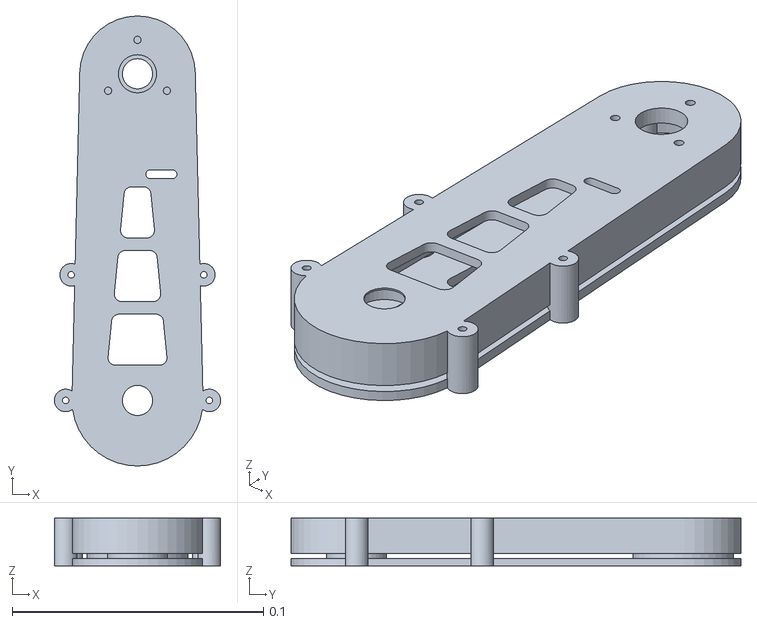
[picture p47: CAD file, 2026-10-24]
sim/meshes/thigh.stl
0.0662 x 0.179 x 0.019
