Munir-Altaher/leg-day/snow_leg/docs/verification/original_print/coupon_fit_test.stl

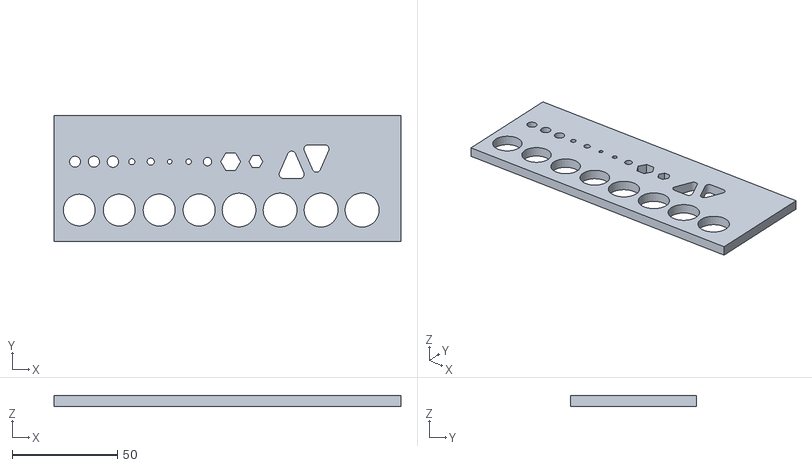
[picture p48: CAD file, 2026-10-24]
snow_leg/docs/verification/original_print/coupon_fit_test.stl
165.0 x 60.0 x 5.00
