Munir-Altaher/leg-day/cad/parts/thigh_cover.STEP

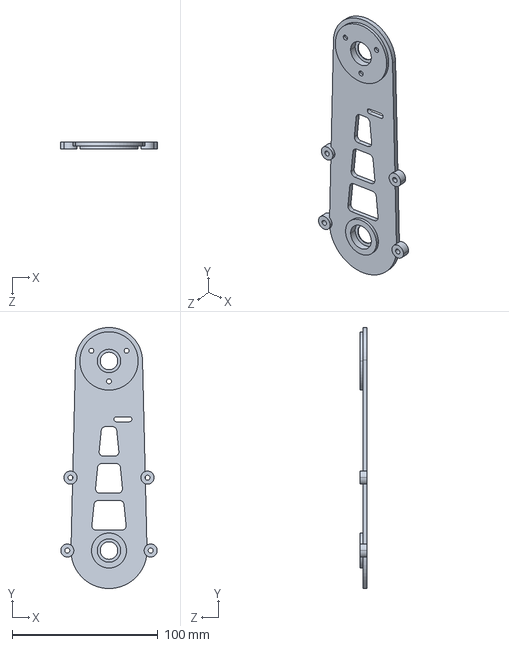
[picture p49: CAD file, 2026-10-24]
cad/parts/thigh_cover.STEP
66.2 x 179.0 x 5.00 mm
