Munir-Altaher/leg-day/snow_leg/cad/stl/assembly_pose/snow_thigh_outer.STL

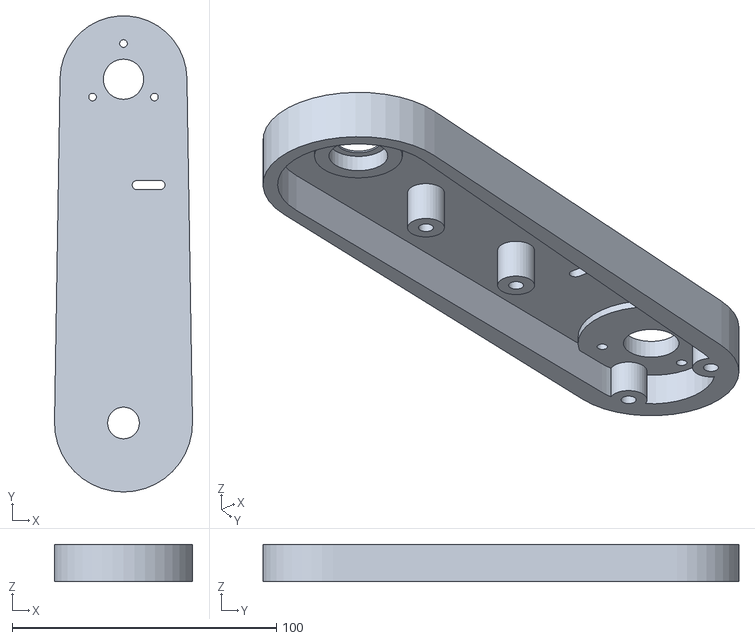
[picture p50: CAD file, 2026-10-24]
snow_leg/cad/stl/assembly_pose/snow_thigh_outer.STL
52.2 x 180.0 x 14.0
