Munir-Altaher/leg-day/snow_leg/docs/verification/original_print/module_frame_inboard.stl

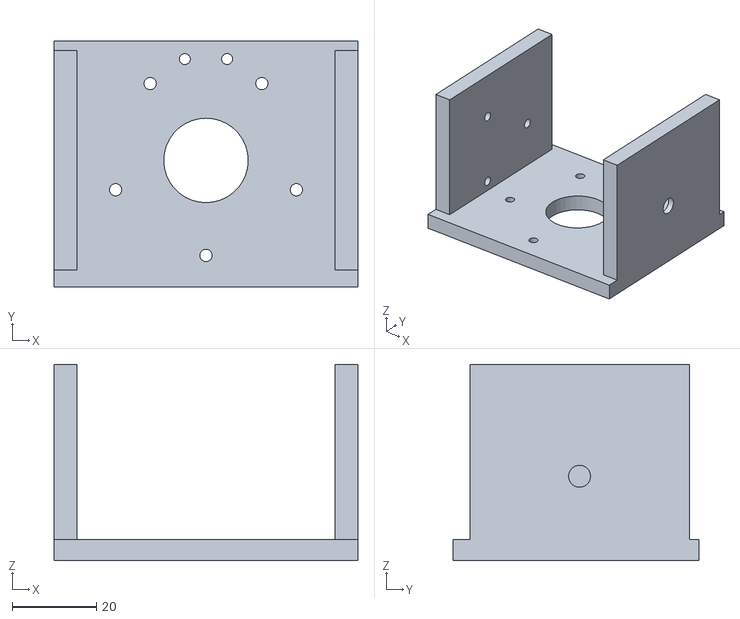
[picture p51: CAD file, 2026-10-24]
snow_leg/docs/verification/original_print/module_frame_inboard.stl
72.0 x 58.3 x 46.5
