Munir-Altaher/leg-day/snow_leg/cad/parts/snow_ref_stop_sleeves.STEP

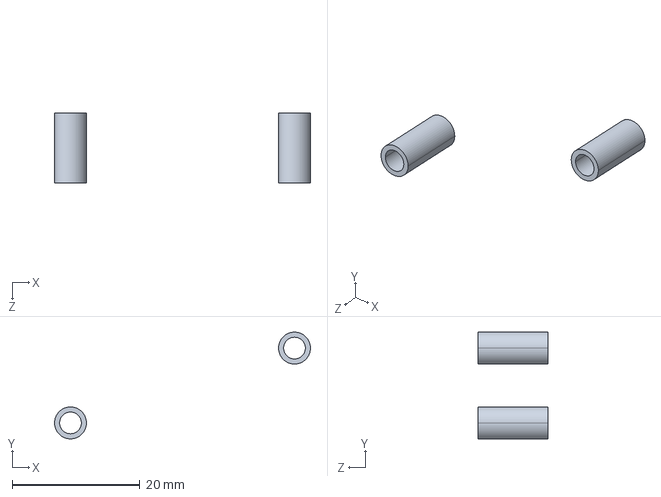
[picture p52: CAD file, 2026-10-24]
snow_leg/cad/parts/snow_ref_stop_sleeves.STEP
40.0 x 16.7 x 11.0 mm
