Munir-Altaher/leg-day/snow_leg/cad/stl/assembly_pose/snow_coupon_fit_test.STL

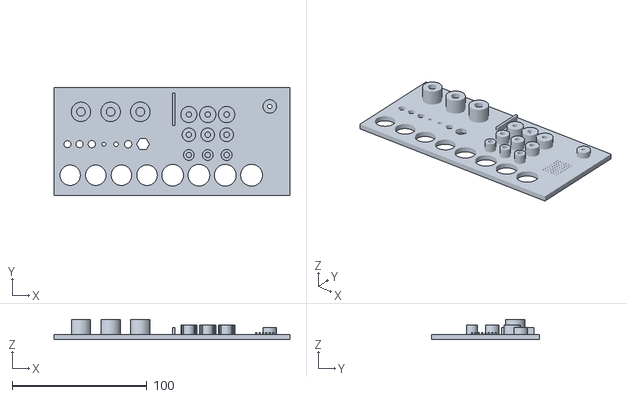
[picture p53: CAD file, 2026-10-24]
snow_leg/cad/stl/assembly_pose/snow_coupon_fit_test.STL
175.0 x 80.0 x 15.1
