Munir-Altaher/leg-day/snow_leg/docs/verification/original_print/rig_plate.stl

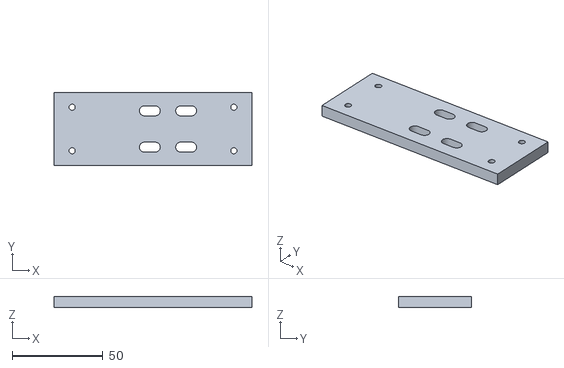
[picture p54: CAD file, 2026-10-24]
snow_leg/docs/verification/original_print/rig_plate.stl
109.1 x 40.0 x 6.00
