Munir-Altaher/leg-day/snow_leg/cad/parts/snow_shank.STEP

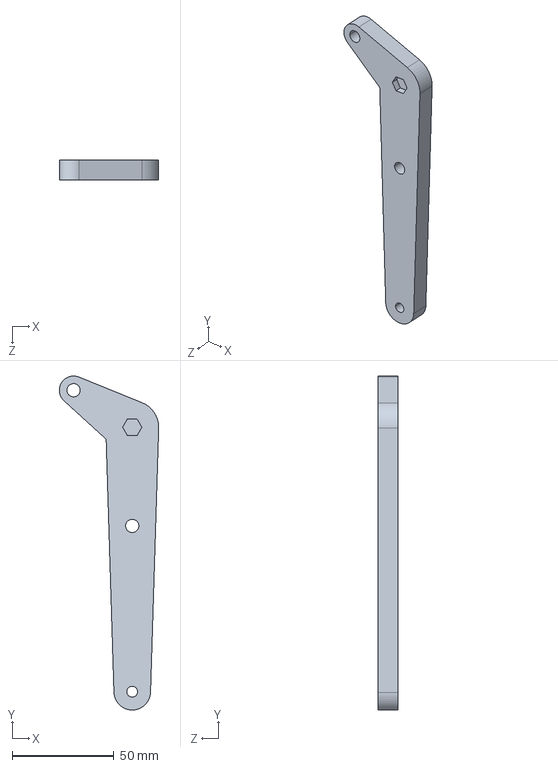
[picture p55: CAD file, 2026-10-24]
snow_leg/cad/parts/snow_shank.STEP
48.8 x 164.2 x 10.0 mm
