Munir-Altaher/leg-day/snow_leg/cad/stl/assembly_pose/snow_thigh_cover.STL

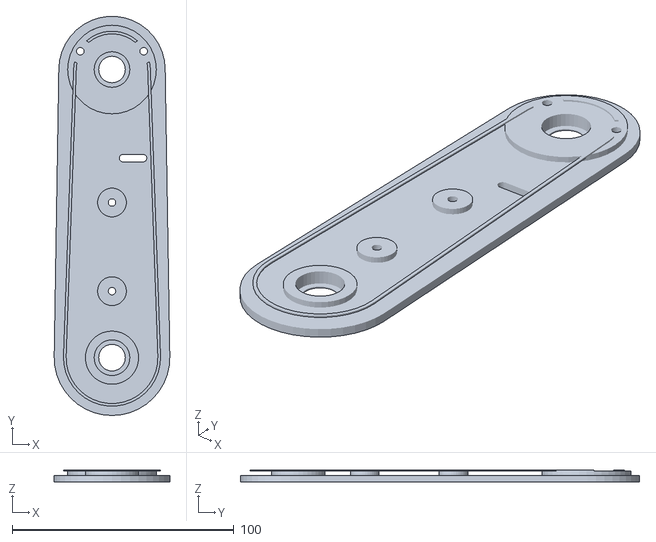
[picture p56: CAD file, 2026-10-24]
snow_leg/cad/stl/assembly_pose/snow_thigh_cover.STL
52.2 x 180.0 x 5.60
