Munir-Altaher/leg-day/snow_leg/docs/verification/original_print/foot.stl

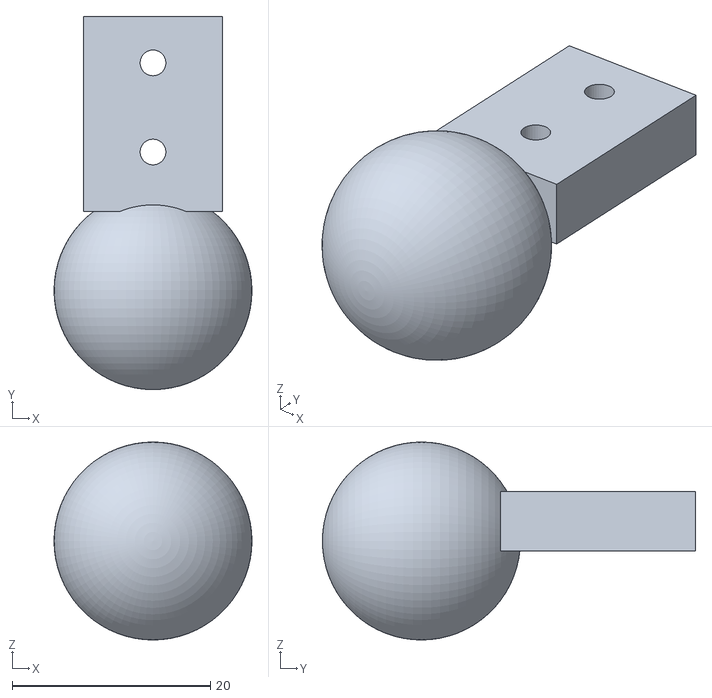
[picture p57: CAD file, 2026-10-24]
snow_leg/docs/verification/original_print/foot.stl
20.0 x 37.7 x 20.0
