Munir-Altaher/leg-day/snow_leg/cad/parts/snow_ref_pulley_20T_kit.STEP

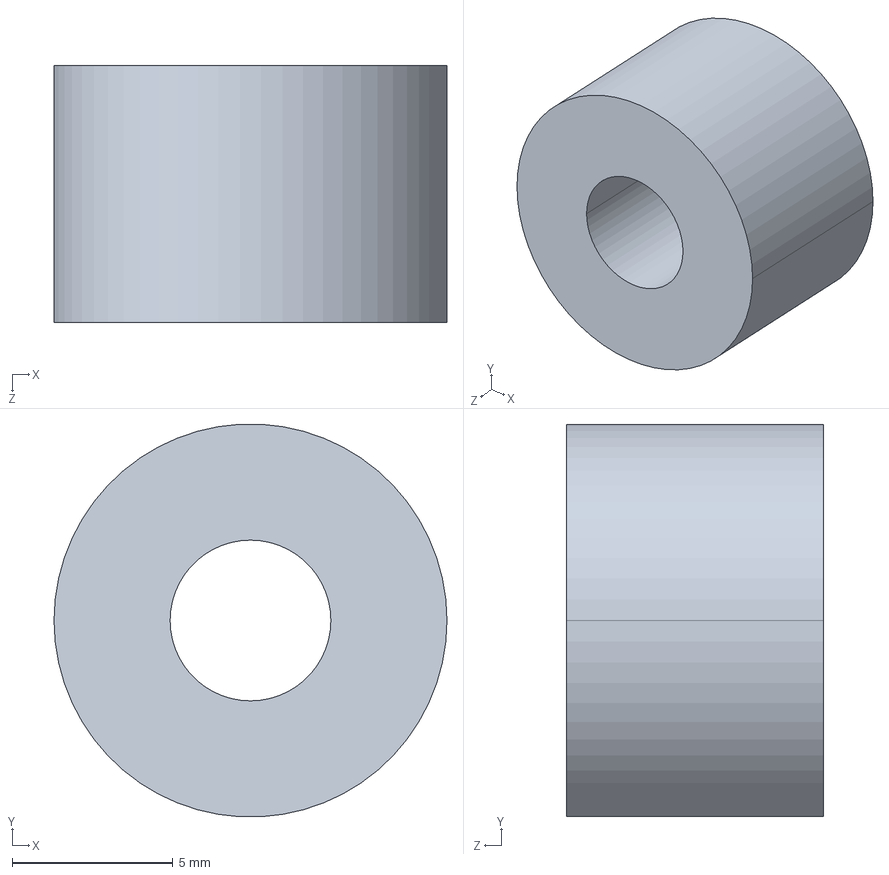
[picture p58: CAD file, 2026-10-24]
snow_leg/cad/parts/snow_ref_pulley_20T_kit.STEP
12.2 x 12.2 x 8.00 mm
