Munir-Altaher/leg-day/snow_leg/cad/stl/assembly_pose/snow_knee_pulley_60T.STL

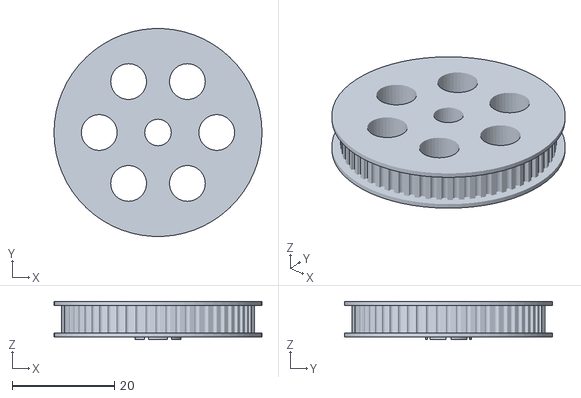
[picture p59: CAD file, 2026-10-24]
snow_leg/cad/stl/assembly_pose/snow_knee_pulley_60T.STL
40.7 x 40.6 x 7.50
