Munir-Altaher/leg-day/snow_leg/docs/verification/original_print/shank.stl

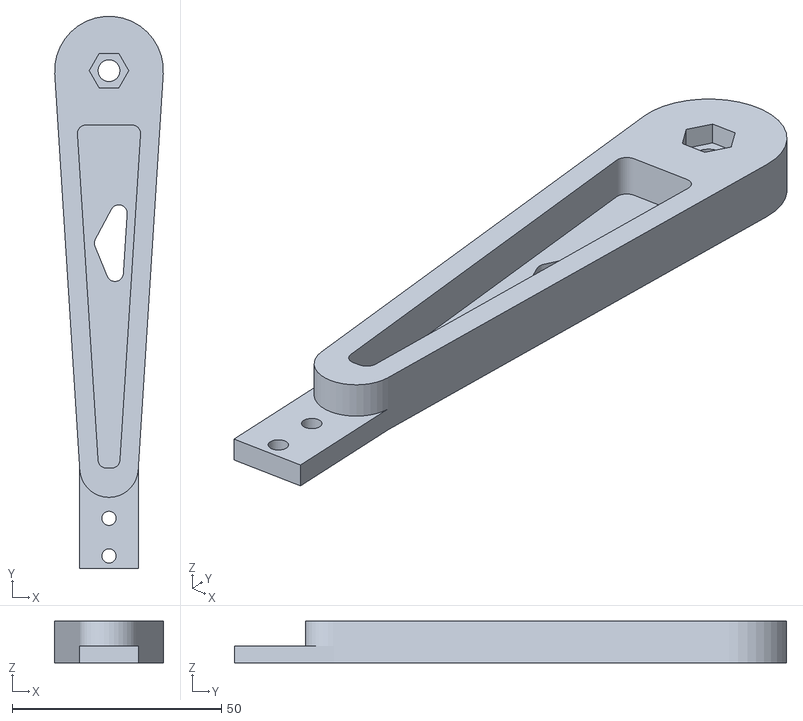
[picture p60: CAD file, 2026-10-24]
snow_leg/docs/verification/original_print/shank.stl
25.9 x 132.0 x 10.0
