Munir-Altaher/leg-day/cad/parts/body_bracket_back.STEP

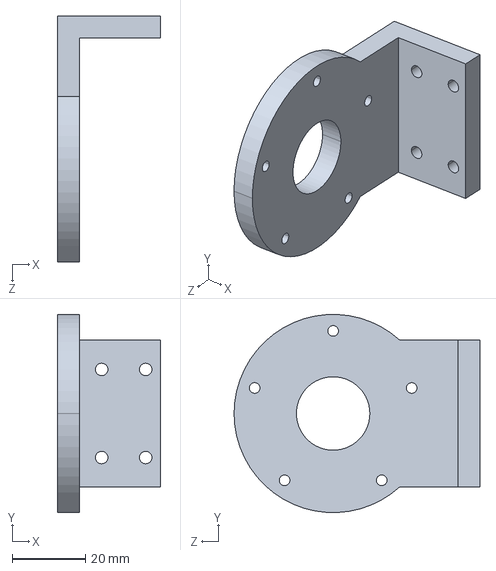
[picture p61: CAD file, 2026-10-24]
cad/parts/body_bracket_back.STEP
28.0 x 53.9 x 67.0 mm
