Munir-Altaher/leg-day/snow_leg/cad/parts/snow_body_bracket_front.STEP

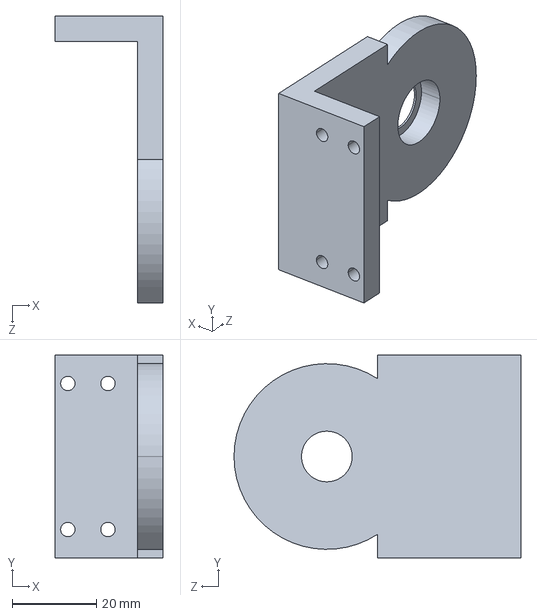
[picture p62: CAD file, 2026-10-24]
snow_leg/cad/parts/snow_body_bracket_front.STEP
25.5 x 48.0 x 68.0 mm
