Munir-Altaher/leg-day/cad/parts/module_plate_inboard.STEP

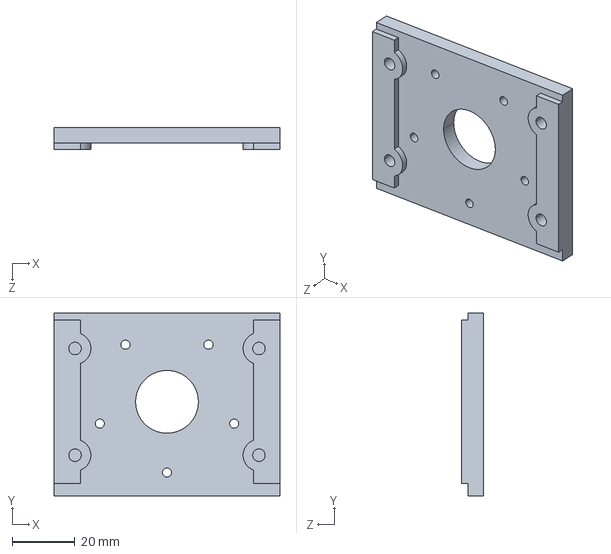
[picture p63: CAD file, 2026-10-24]
cad/parts/module_plate_inboard.STEP
72.0 x 58.3 x 7.00 mm
