Munir-Altaher/leg-day/snow_leg/docs/verification/original_print/thigh_outer.stl

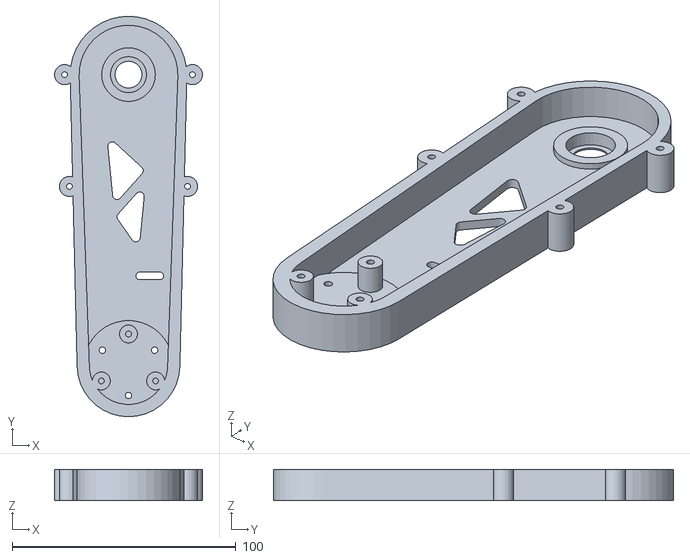
[picture p65: CAD file, 2026-10-24]
snow_leg/docs/verification/original_print/thigh_outer.stl
66.2 x 179.1 x 14.0
