Munir-Altaher/leg-day/cad/parts/rig_plate.STEP

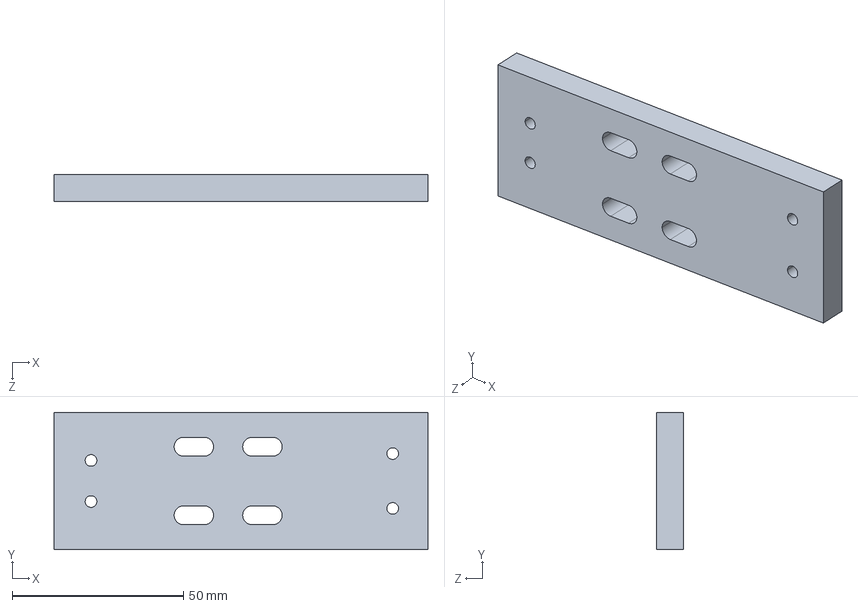
[picture p66: CAD file, 2026-10-24]
cad/parts/rig_plate.STEP
109.1 x 40.0 x 8.00 mm
