Munir-Altaher/leg-day/snow_leg/docs/verification/original_print/body_bracket_back.stl

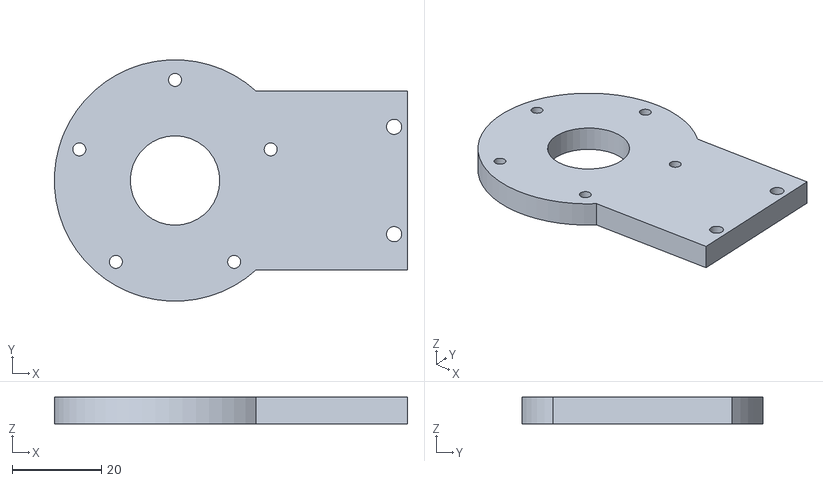
[picture p67: CAD file, 2026-10-24]
snow_leg/docs/verification/original_print/body_bracket_back.stl
79.0 x 53.9 x 6.00
