Munir-Altaher/leg-day/cad/parts/module_plate_outboard.SLDPRT

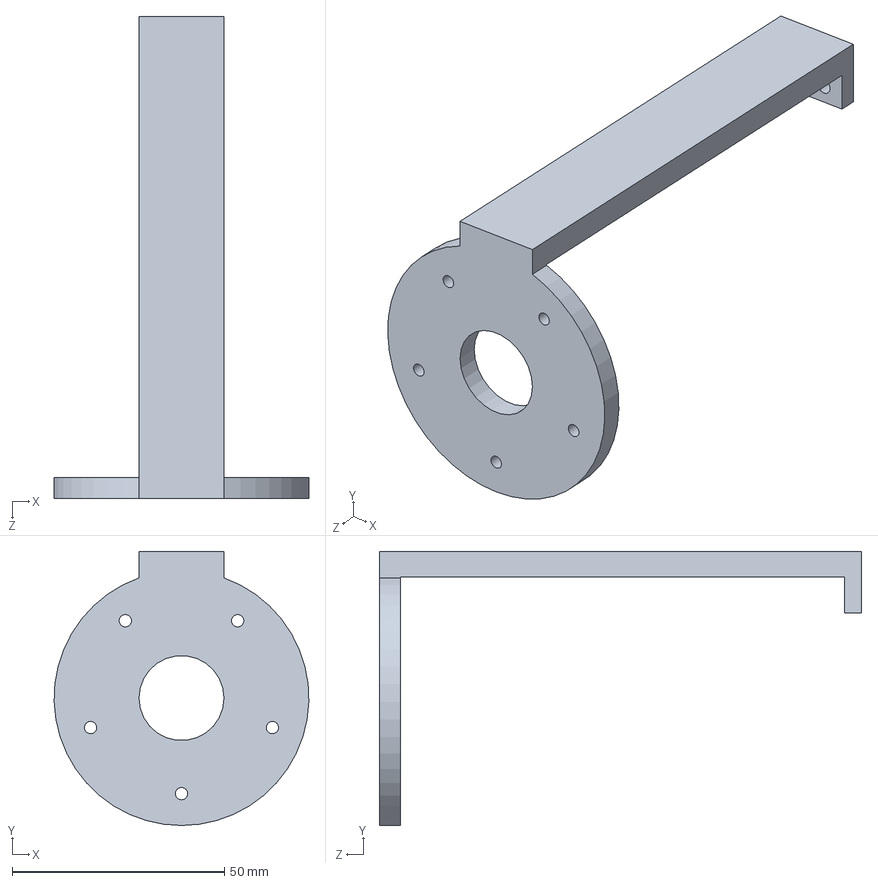
[picture p68: CAD file, 2026-10-24]
cad/parts/module_plate_outboard.SLDPRT
60.0 x 64.5 x 113.5 mm
