Munir-Altaher/leg-day/snow_leg/docs/verification/original_print/module_plate_outboard.stl

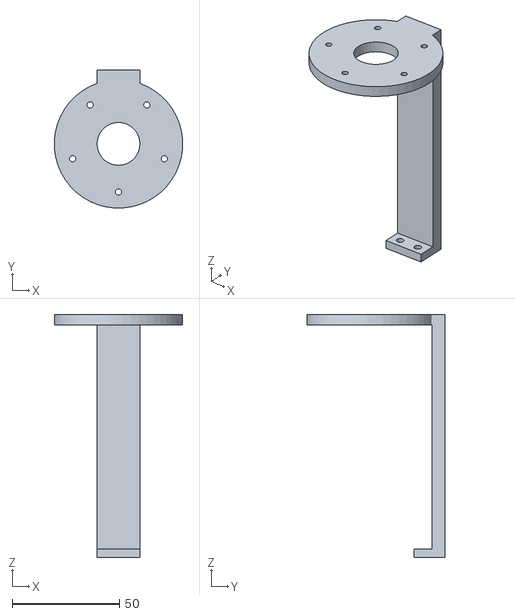
[picture p69: CAD file, 2026-10-24]
snow_leg/docs/verification/original_print/module_plate_outboard.stl
59.9 x 64.4 x 113.5
