Munir-Altaher/leg-day/snow_leg/cad/stl/assembly_pose/snow_hip_shroud_out.STL

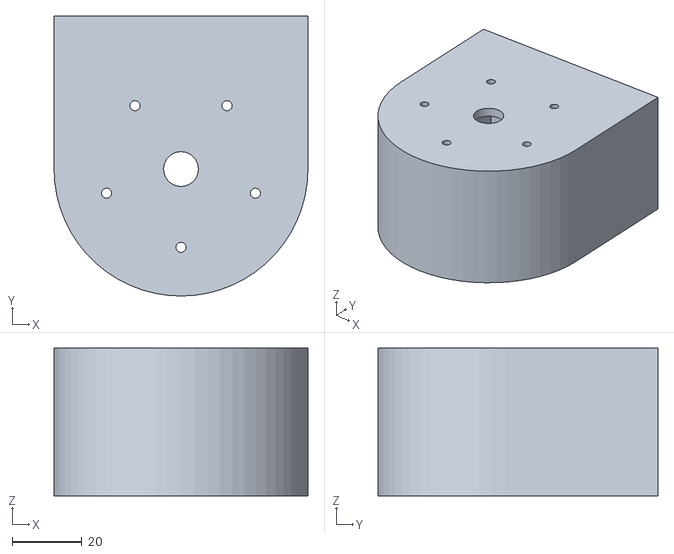
[picture p70: CAD file, 2026-10-24]
snow_leg/cad/stl/assembly_pose/snow_hip_shroud_out.STL
73.0 x 80.5 x 42.5
