Munir-Altaher/leg-day/cad/parts/ref_ground.STEP

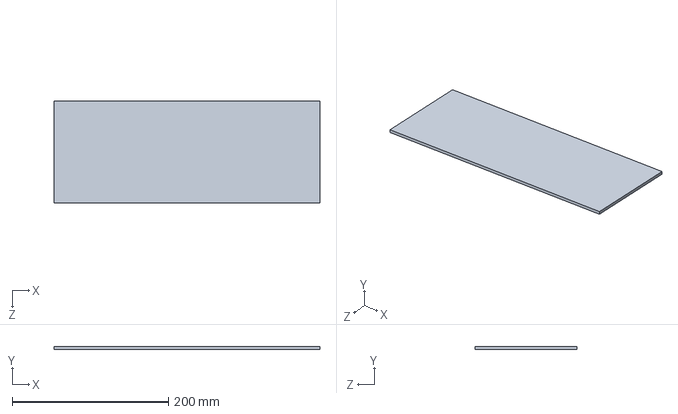
[picture p71: CAD file, 2026-10-24]
cad/parts/ref_ground.STEP
340.0 x 4.00 x 130.0 mm
