Munir-Altaher/leg-day/cad/parts/body_spine.STEP

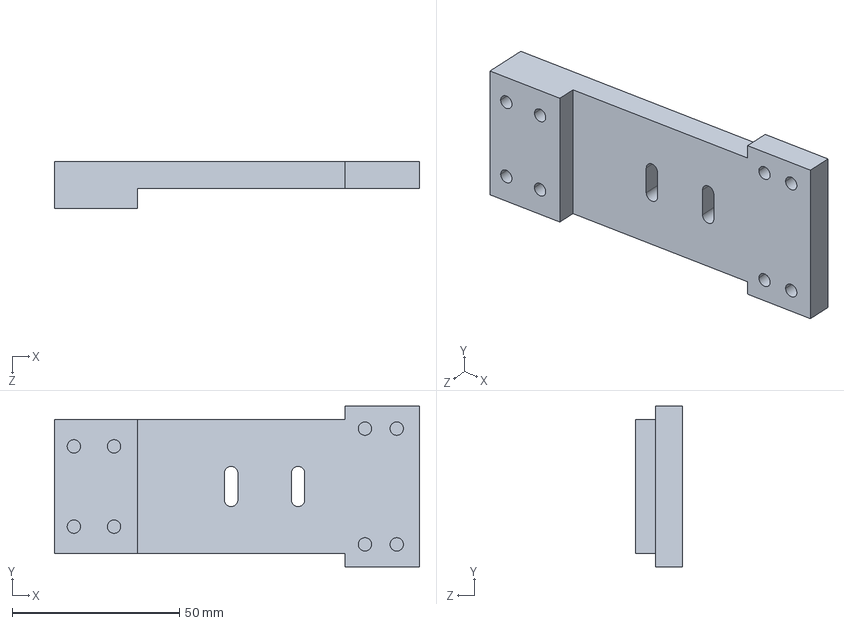
[picture p72: CAD file, 2026-10-24]
cad/parts/body_spine.STEP
109.1 x 48.0 x 14.0 mm
