Munir-Altaher/leg-day/snow_leg/cad/parts/snow_ref_ankle_pin.STEP

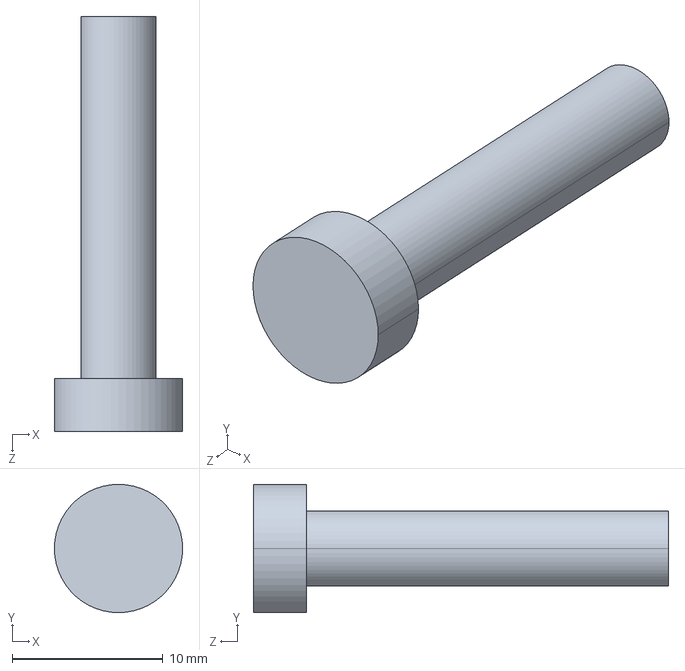
[picture p73: CAD file, 2026-10-24]
snow_leg/cad/parts/snow_ref_ankle_pin.STEP
8.50 x 8.50 x 27.5 mm
