Munir-Altaher/leg-day/cad/parts/module_flange_front.STEP

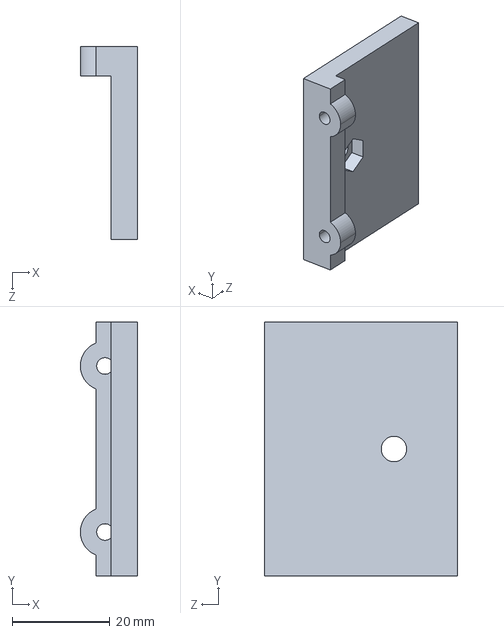
[picture p74: CAD file, 2026-10-24]
cad/parts/module_flange_front.STEP
11.7 x 52.0 x 39.5 mm
