Munir-Altaher/leg-day/snow_leg/cad/parts/snow_module_frame_outboard.STEP

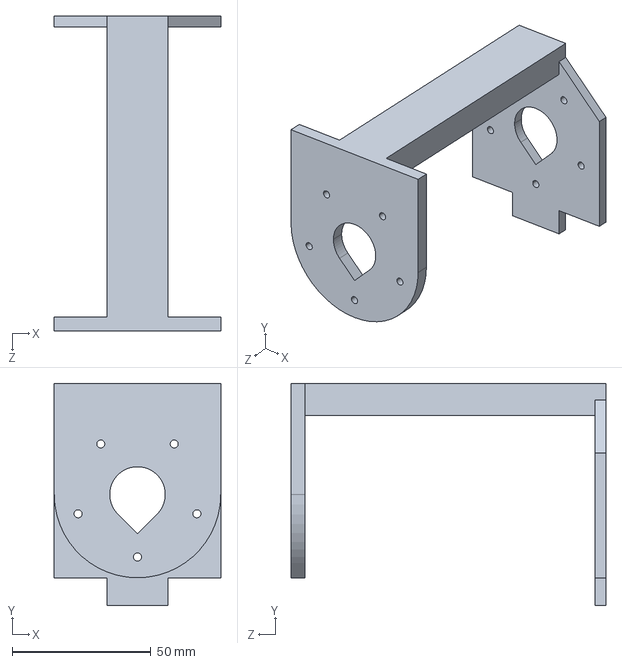
[picture p75: CAD file, 2026-10-24]
snow_leg/cad/parts/snow_module_frame_outboard.STEP
60.0 x 80.0 x 113.5 mm
