Munir-Altaher/leg-day/snow_leg/cad/stl/assembly_pose/snow_body_spine.STL

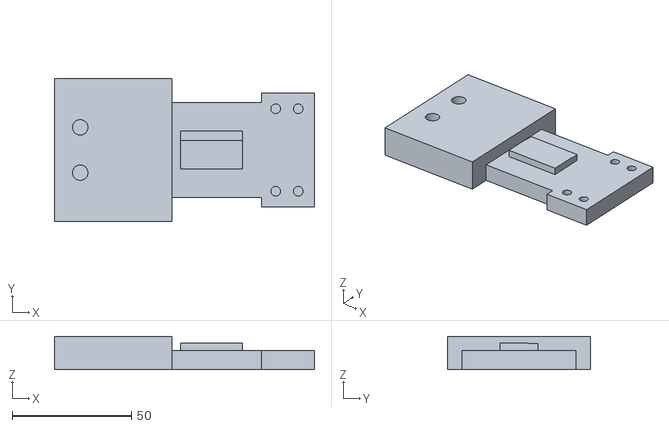
[picture p76: CAD file, 2026-10-24]
snow_leg/cad/stl/assembly_pose/snow_body_spine.STL
109.1 x 60.0 x 14.0
