Munir-Altaher/leg-day/cad/parts/shank.STEP

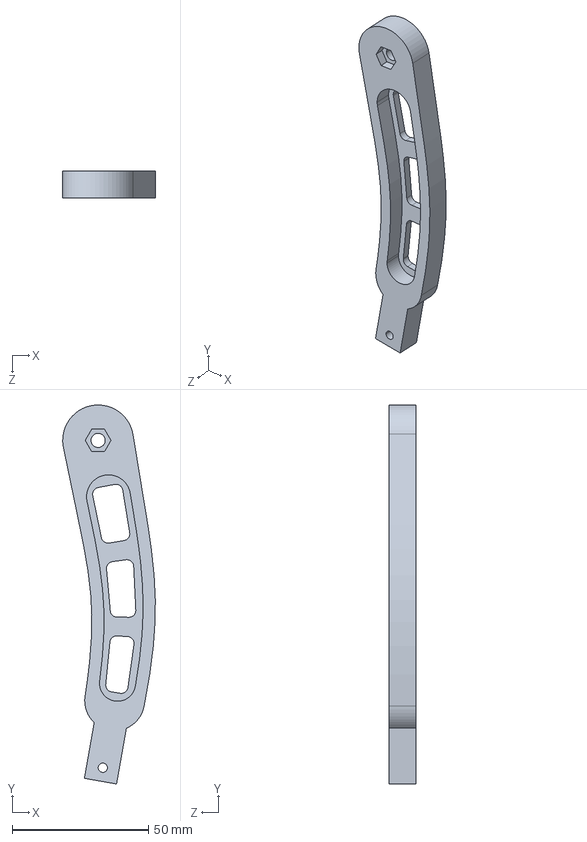
[picture p77: CAD file, 2026-10-24]
cad/parts/shank.STEP
34.0 x 139.1 x 10.0 mm
