Munir-Altaher/leg-day/cad/parts/thigh_outer.STEP

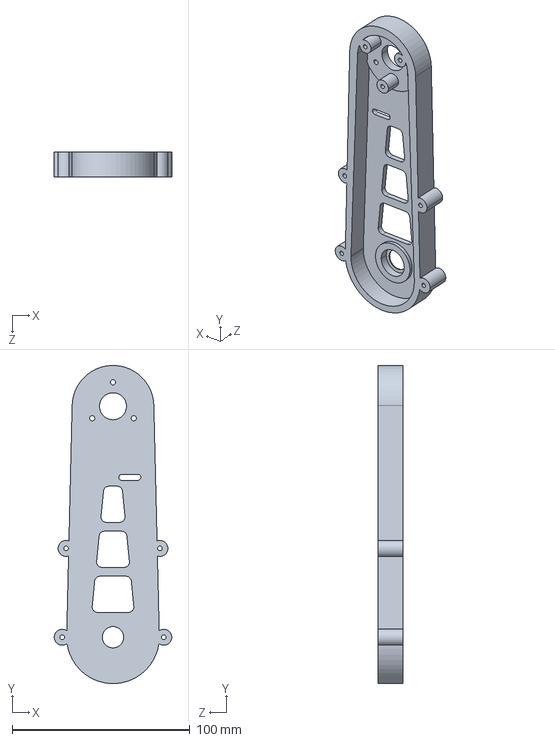
[picture p78: CAD file, 2026-10-24]
cad/parts/thigh_outer.STEP
66.2 x 179.0 x 14.0 mm
