Munir-Altaher/leg-day/cad/parts/hip_module.SLDASM

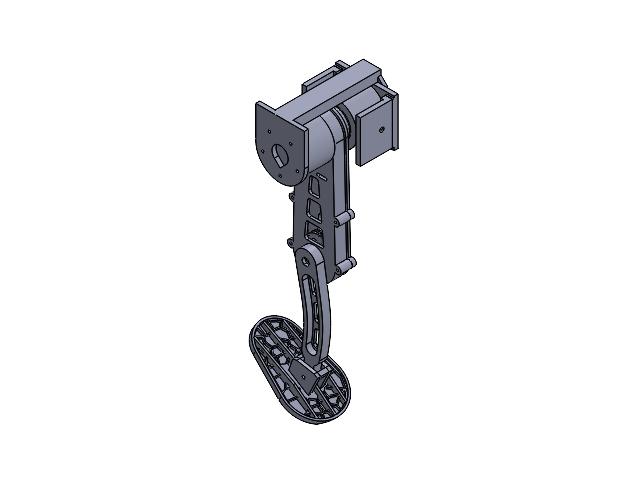
[picture p80: CAD file, 2026-10-24]
cad/parts/hip_module.SLDASM
module_plate_inboard
module_flange_back
module_flange_front
module_frame_outboard
ref_motor_hip
ref_motor_knee
hip_shaft_adapter
ref_pulley_20T_kit
thigh_outer
thigh_cover
knee_pulley_60T
shank
snowshoe
