Munir-Altaher/leg-day/snow_leg/cad/parts/snow_hip_module.SLDASM

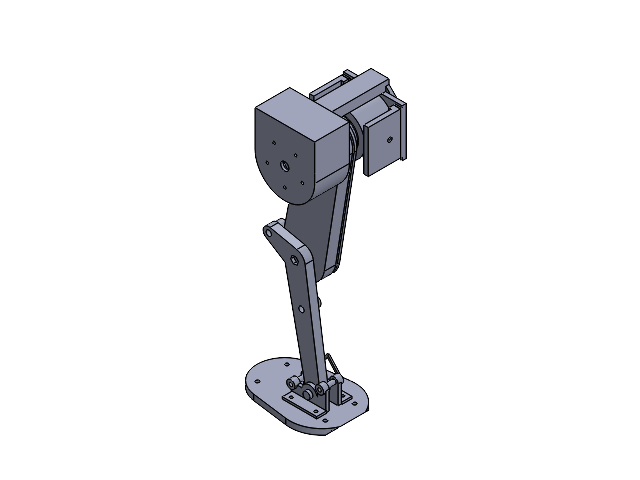
[picture p81: CAD file, 2026-10-24]
snow_leg/cad/parts/snow_hip_module.SLDASM
snow_module_plate_inboard
snow_module_flange_back
snow_module_flange_front
snow_module_frame_outboard
snow_hip_shroud_out
snow_ref_motor_hip
snow_ref_motor_knee
snow_hip_shaft_adapter
snow_ref_pulley_20T_kit
snow_thigh_outer
snow_thigh_cover
snow_knee_pulley_60T
snow_ref_knee_post_sleeves
snow_shank
snow_foot_snowshoe
snow_ankle_bracket_in
snow_ankle_bracket_out
snow_ref_ankle_pin
snow_ref_stop_sleeves
snow_ref_springs
