Munir-Altaher/leg-day/cad/parts/walk_anim.SLDASM

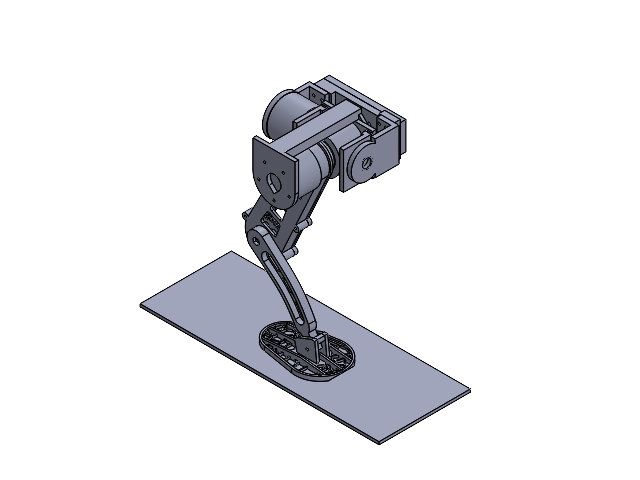
[picture p83: CAD file, 2026-10-24]
cad/parts/walk_anim.SLDASM
module_plate_inboard
module_flange_back
module_flange_front
module_frame_outboard
ref_motor_hip
ref_motor_knee
hip_shaft_adapter
ref_pulley_20T_kit
thigh_outer
thigh_cover
knee_pulley_60T
shank
snowshoe
ref_motor_abad
body_bracket_back
body_bracket_front
body_spine
rig_plate
ref_ground
