Munir-Altaher/leg-day/(list of files, cad)

Other CAD files:
snow_leg/cad/stl/assembly_pose/snow_foot_snowshoe.STL
snow_leg/cad/parts/snow_ref_motor_abad.STEP
snow_leg/cad/stl/assembly_pose/snow_hip_shaft_adapter.STL
snow_leg/cad/parts/snow_ref_motor_hip.STEP
cad/parts/module_flange_back.STEP
cad/parts/ref_motor_abad.STEP
snow_leg/cad/stl/assembly_pose/snow_ref_motor_abad.STL
snow_leg/docs/verification/original_print/hip_shaft_adapter.stl
snow_leg/cad/parts/snow_ref_motor_knee.STEP
snow_leg/cad/parts/snow_knee_pulley_60T.STEP
snow_leg/cad/stl/assembly_pose/snow_body_bracket_back.STL
snow_leg/cad/parts/snow_body_bracket_back.STEP
snow_leg/cad/stl/assembly_pose/snow_ankle_bracket_in.STL
cad/parts/coupon_fit_test.STEP
snow_leg/cad/parts/snow_ref_ground.STEP
snow_leg/cad/parts/snow_hip_shroud_out.STEP
snow_leg/cad/stl/assembly_pose/snow_ref_stop_sleeves.STL
cad/parts/knee_pulley_60T.STEP
snow_leg/cad/stl/assembly_pose/snow_body_bracket_front.STL
cad/parts/module_frame_inboard.SLDPRT
snow_leg/cad/stl/assembly_pose/snow_ref_motor_hip.STL
snow_leg/cad/stl/assembly_pose/snow_ref_ankle_pin.STL
cad/parts/ref_pulley_20T_kit.STEP
snow_leg/cad/parts/snow_thigh_cover.STEP
snow_leg/cad/stl/assembly_pose/snow_module_frame_outboard.STL
cad/parts/body_bracket_front.STEP
snow_leg/cad/parts/snow_body_spine.STEP
snow_leg/cad/stl/assembly_pose/snow_ref_pulley_20T_kit.STL
snow_leg/cad/stl/assembly_pose/snow_ankle_bracket_out.STL
snow_leg/cad/parts/snow_coupon_fit_test.STEP
snow_leg/cad/stl/assembly_pose/snow_ref_motor_knee.STL
snow_leg/cad/parts/snow_module_flange_front.STEP
snow_leg/cad/stl/assembly_pose/snow_rig_plate.STL
snow_leg/cad/parts/snow_thigh_outer.STEP
snow_leg/cad/stl/assembly_pose/snow_module_plate_inboard.STL
snow_leg/cad/parts/snow_ankle_bracket_in.STEP
snow_leg/cad/stl/assembly_pose/snow_shank.STL
snow_leg/cad/parts/snow_module_plate_inboard.STEP
snow_leg/cad/parts/snow_hip_shaft_adapter.STEP
3D Print/body_bracket_back.SLDPRT
3D Print/body_bracket_front.SLDPRT
3D Print/body_spine.SLDPRT
3D Print/coupon_fit_test.SLDPRT
3D Print/hip_shaft_adapter.SLDPRT
3D Print/knee_pulley_60T.SLDPRT
3D Print/module_flange_back.SLDPRT
3D Print/module_flange_front.SLDPRT
3D Print/module_frame_outboard.SLDPRT
3D Print/module_plate_inboard.SLDPRT
3D Print/rig_plate.SLDPRT
3D Print/shank.SLDPRT
3D Print/snowshoe.SLDPRT
3D Print/thigh_cover.SLDPRT
3D Print/thigh_outer.SLDPRT
cad/parts/body_bracket_back.SLDPRT
cad/parts/body_bracket_front.SLDPRT
cad/parts/body_spine.SLDPRT
cad/parts/coupon_fit_test.SLDPRT
cad/parts/hip_shaft_adapter.SLDPRT
cad/parts/knee_pulley_60T.SLDPRT
cad/parts/module_flange_back.SLDPRT
cad/parts/module_flange_front.SLDPRT
cad/parts/module_frame_outboard.SLDPRT
cad/parts/module_plate_inboard.SLDPRT
cad/parts/ref_ground.SLDPRT
cad/parts/ref_motor_abad.SLDPRT
cad/parts/ref_motor_hip.SLDPRT
cad/parts/ref_motor_knee.SLDPRT
cad/parts/ref_pulley_20T_kit.SLDPRT
cad/parts/rig_plate.SLDPRT
cad/parts/shank.SLDPRT
cad/parts/snowshoe.SLDPRT
cad/parts/thigh_cover.SLDPRT
cad/parts/thigh_outer.SLDPRT
cad/stl/body_bracket_back.STL
cad/stl/body_bracket_front.STL
cad/stl/body_spine.STL
cad/stl/coupon_fit_test.STL
cad/stl/hip_shaft_adapter.STL
cad/stl/knee_pulley_60T.STL
cad/stl/module_flange_back.STL
cad/stl/module_flange_front.STL
cad/stl/module_frame_outboard.STL
cad/stl/module_plate_inboard.STL
cad/stl/print/body_bracket_back.stl
cad/stl/print/body_bracket_front.stl
cad/stl/print/body_spine.stl
cad/stl/print/hip_shaft_adapter.stl
cad/stl/print/knee_pulley_60T.stl
cad/stl/print/module_flange_back.stl
cad/stl/print/module_flange_front.stl
cad/stl/print/module_frame_outboard.stl
cad/stl/print/module_plate_inboard.stl
cad/stl/print/rig_plate.stl
cad/stl/print/shank.stl
cad/stl/print/snowshoe.stl
cad/stl/print/thigh_cover.stl
cad/stl/print/thigh_outer.stl
cad/stl/ref_ground.STL
cad/stl/ref_motor_abad.STL
cad/stl/ref_motor_hip.STL
cad/stl/ref_motor_knee.STL
cad/stl/ref_pulley_20T_kit.STL
cad/stl/rig_plate.STL
cad/stl/shank.STL
cad/stl/snowshoe.STL
cad/stl/thigh_cover.STL
cad/stl/thigh_outer.STL
snow_leg/cad/parts/snow_ankle_bracket_in.SLDPRT
snow_leg/cad/parts/snow_ankle_bracket_out.SLDPRT
snow_leg/cad/parts/snow_body_bracket_back.SLDPRT
snow_leg/cad/parts/snow_body_bracket_front.SLDPRT
snow_leg/cad/parts/snow_body_spine.SLDPRT
snow_leg/cad/parts/snow_coupon_fit_test.SLDPRT
snow_leg/cad/parts/snow_foot_snowshoe.SLDPRT
snow_leg/cad/parts/snow_hip_shaft_adapter.SLDPRT
snow_leg/cad/parts/snow_hip_shroud_out.SLDPRT
snow_leg/cad/parts/snow_knee_pulley_60T.SLDPRT
snow_leg/cad/parts/snow_module_flange_back.SLDPRT
snow_leg/cad/parts/snow_module_flange_front.SLDPRT
snow_leg/cad/parts/snow_module_frame_outboard.SLDPRT
snow_leg/cad/parts/snow_module_plate_inboard.SLDPRT
snow_leg/cad/parts/snow_ref_ankle_pin.SLDPRT
snow_leg/cad/parts/snow_ref_ground.SLDPRT
snow_leg/cad/parts/snow_ref_knee_post_sleeves.SLDPRT
snow_leg/cad/parts/snow_ref_motor_abad.SLDPRT
snow_leg/cad/parts/snow_ref_motor_hip.SLDPRT
snow_leg/cad/parts/snow_ref_motor_knee.SLDPRT
snow_leg/cad/parts/snow_ref_pulley_20T_kit.SLDPRT
snow_leg/cad/parts/snow_ref_springs.SLDPRT
snow_leg/cad/parts/snow_ref_stop_sleeves.SLDPRT
snow_leg/cad/parts/snow_rig_plate.SLDPRT
snow_leg/cad/parts/snow_shank.SLDPRT
snow_leg/cad/parts/snow_thigh_cover.SLDPRT
snow_leg/cad/parts/snow_thigh_outer.SLDPRT
snow_leg/cad/stl/snow_ankle_bracket_in.stl
snow_leg/cad/stl/snow_ankle_bracket_out.stl
snow_leg/cad/stl/snow_body_bracket_back.stl
snow_leg/cad/stl/snow_body_bracket_front.stl
snow_leg/cad/stl/snow_body_spine.stl
snow_leg/cad/stl/snow_coupon_fit_test.stl
snow_leg/cad/stl/snow_foot_snowshoe.stl
snow_leg/cad/stl/snow_hip_shaft_adapter.stl
snow_leg/cad/stl/snow_hip_shroud_out.stl
snow_leg/cad/stl/snow_knee_pulley_60T.stl
snow_leg/cad/stl/snow_module_flange_back.stl
snow_leg/cad/stl/snow_module_flange_front.stl
snow_leg/cad/stl/snow_module_frame_outboard.stl
snow_leg/cad/stl/snow_module_plate_inboard.stl
snow_leg/cad/stl/snow_rig_plate.stl
snow_leg/cad/stl/snow_shank.stl
snow_leg/cad/stl/snow_thigh_cover.stl
snow_leg/cad/stl/snow_thigh_outer.stl
