Munir-Altaher/leg-day/sim/runs/backflip_v2_fake_landings/train_log_part6_soft_cumulative_bug.txt

round    1  steps 10106880  mean episode reward    35.22  (    2 s)
round    2  steps 10113024  mean episode reward    30.28  (    4 s)
round    3  steps 10119168  mean episode reward    31.62  (    7 s)  | replay: turned    289 deg, no landing
round    4  steps 10125312  mean episode reward    32.13  (   11 s)
round    5  steps 10131456  mean episode reward    31.37  (   13 s)
round    6  steps 10137600  mean episode reward    32.38  (   16 s)  | replay: turned    284 deg, no landing
round    7  steps 10143744  mean episode reward    40.02  (   20 s)
round    8  steps 10149888  mean episode reward    44.13  (   23 s)
round    9  steps 10156032  mean episode reward    48.61  (   26 s)  | replay: turned    305 deg, no landing
round   10  steps 10162176  mean episode reward    47.14  (   29 s)
round   11  steps 10168320  mean episode reward    54.09  (   32 s)
round   12  steps 10174464  mean episode reward    53.05  (   35 s)  | replay: turned    297 deg, no landing
round   13  steps 10180608  mean episode reward    51.82  (   38 s)
round   14  steps 10186752  mean episode reward    54.32  (   41 s)
round   15  steps 10192896  mean episode reward    67.28  (   44 s)  | replay: turned    333 deg, no landing
round   16  steps 10199040  mean episode reward    71.05  (   47 s)
round   17  steps 10205184  mean episode reward    67.60  (   50 s)
round   18  steps 10211328  mean episode reward    68.66  (   52 s)  | replay: turned    329 deg, no landing
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
round  466  steps 12963840  mean episode reward   151.88  ( 1360 s)
round  467  steps 12969984  mean episode reward   149.14  ( 1363 s)
round  468  steps 12976128  mean episode reward   141.84  ( 1366 s)  | replay: turned    308 deg, no landing
round  469  steps 12982272  mean episode reward   148.90  ( 1369 s)
round  470  steps 12988416  mean episode reward   147.75  ( 1372 s)
round  471  steps 12994560  mean episode reward   151.53  ( 1375 s)  | replay: turned    355 deg, no landing
round  472  steps 13000704  mean episode reward   153.72  ( 1378 s)
round  473  steps 13006848  mean episode reward   157.12  ( 1381 s)
round  474  steps 13012992  mean episode reward   149.41  ( 1384 s)  | replay: turned    338 deg, no landing
round  475  steps 13019136  mean episode reward   148.01  ( 1388 s)
round  476  steps 13025280  mean episode reward   164.62  ( 1391 s)
round  477  steps 13031424  mean episode reward   149.32  ( 1394 s)  | replay: turned    321 deg, no landing
round  478  steps 13037568  mean episode reward   127.42  ( 1397 s)
round  479  steps 13043712  mean episode reward   135.73  ( 1400 s)
round  480  steps 13049856  mean episode reward   139.09  ( 1403 s)  | replay: turned    332 deg, no landing
round  481  steps 13056000  mean episode reward   141.87  ( 1407 s)
round  482  steps 13062144  mean episode reward   140.97  ( 1409 s)
round  483  steps 13068288  mean episode reward   144.55  ( 1412 s)  | replay: turned    311 deg, no landing
round  484  steps 13074432  mean episode reward   134.12  ( 1415 s)
round  485  steps 13080576  mean episode reward   139.64  ( 1418 s)
round  486  steps 13086720  mean episode reward   146.62  ( 1421 s)  | replay: turned    338 deg, no landing
round  487  steps 13092864  mean episode reward   153.13  ( 1425 s)
round  488  steps 13099008  mean episode reward   151.94  ( 1428 s)
round  489  steps 13105152  mean episode reward   148.85  ( 1431 s)  | replay: turned    295 deg, no landing
round  490  steps 13111296  mean episode reward   136.69  ( 1435 s)
round  491  steps 13117440  mean episode reward   144.66  ( 1438 s)
round  492  steps 13123584  mean episode reward   131.89  ( 1441 s)  | replay: turned    336 deg, no landing
round  493  steps 13129728  mean episode reward   134.64  ( 1445 s)
round  494  steps 13135872  mean episode reward   134.36  ( 1448 s)
round  495  steps 13142016  mean episode reward   147.67  ( 1450 s)  | replay: turned    324 deg, no landing
round  496  steps 13148160  mean episode reward   147.01  ( 1454 s)
round  497  steps 13154304  mean episode reward   157.98  ( 1457 s)
