Munir-Altaher/leg-day/snow_leg/cad/parts/build_log.txt

building snow_thigh_outer
   {'bbox_mm': [-26.1, -156.1, 33.5, 26.1, 24.0, 47.5], 'volume_mm3': 53581, 'solid_pla_g': 66.4, 'skeleton': True}
building snow_thigh_cover
   {'bbox_mm': [-26.1, -156.1, 28.5, 26.1, 24.0, 34.1], 'volume_mm3': 27098, 'solid_pla_g': 33.6, 'skeleton': True}
building snow_knee_pulley
   {'bbox_mm': [-20.34, -150.34, 34.0, 20.34, -109.66, 42.0], 'volume_mm3': 6010, 'solid_pla_g': 7.5, 'skeleton': True}
building snow_shank
   {'bbox_mm': [-39.09, -269.0, 48.0, 13.0, -101.55, 58.0], 'volume_mm3': 38252, 'solid_pla_g': 47.4, 'skeleton': True}
building snow_foot_snowshoe
   {'bbox_mm': [-73.49, -277.01, -27.0, 48.51, -265.0, 93.0], 'volume_mm3': 25726, 'solid_pla_g': 31.9, 'skeleton': True, 'papillae': 224}
building snow_ankle_bracket_in
   {'bbox_mm': [-24.65, -270.0, 31.0, 21.2, -242.76, 47.5], 'volume_mm3': 4785, 'solid_pla_g': 5.9, 'skeleton': True}
building snow_ankle_bracket_out
   {'bbox_mm': [-24.65, -270.0, 58.5, 21.2, -242.76, 75.0], 'volume_mm3': 5301, 'solid_pla_g': 6.6, 'skeleton': True}
building snow_ref_ankle_pin
   {'bbox_mm': [-4.25, -264.25, 38.0, 4.25, -255.75, 66.5], 'volume_mm3': 689, 'solid_pla_g': 0.9, 'skeleton': True}
building snow_ref_stop_sleeves
   {'bbox_mm': [-20.5, -262.78, 47.5, 17.05, -246.91, 58.5], 'volume_mm3': 232, 'solid_pla_g': 0.3, 'skeleton': True}
building snow_ref_springs
   {'bbox_mm': [-42.94, -265.17, 39.0, 40.97, -228.83, 41.0], 'volume_mm3': 635, 'solid_pla_g': 0.8, 'skeleton': True}
building snow_ref_knee_post_sleeves
   {'bbox_mm': [-34.84, -202.5, 40.0, 6.0, -105.8, 48.0], 'volume_mm3': 1429, 'solid_pla_g': 1.8, 'skeleton': True}
building snow_hip_shaft_adapter
   {'bbox_mm': [-18.0, -18.0, 22.0, 18.0, 18.0, 28.5], 'volume_mm3': 5459, 'solid_pla_g': 6.8, 'skeleton': True}
building snow_module_plate_inboard
   {'bbox_mm': [-37.65, -30.0, -20.0, 37.65, 40.0, 84.5], 'volume_mm3': 47479, 'solid_pla_g': 58.9, 'skeleton': True}
building snow_module_flange_back
   {'bbox_mm': [-37.65, -26.0, -13.0, -24.35, 26.0, 26.5], 'volume_mm3': 12249, 'solid_pla_g': 15.2, 'skeleton': True}
building snow_module_flange_front
   {'bbox_mm': [24.35, -26.0, -13.0, 37.65, 26.0, 26.5], 'volume_mm3': 12295, 'solid_pla_g': 15.2, 'skeleton': True}
building snow_module_plate_outboard
   {'bbox_mm': [-30.0, -30.0, 84.5, 30.0, 40.0, 89.5], 'volume_mm3': 13486, 'solid_pla_g': 16.7, 'skeleton': True}
building snow_hip_shroud_out
   {'bbox_mm': [-34.0, -34.0, 50.0, 34.0, 45.0, 92.5], 'volume_mm3': 27639, 'solid_pla_g': 34.3, 'skeleton': True}
building snow_body_bracket_back
   {'bbox_mm': [-79.0, -27.0, -40.0, -51.0, 27.0, 27.0], 'volume_mm3': 20428, 'solid_pla_g': 25.3, 'skeleton': True}
building snow_body_bracket_front
   {'bbox_mm': [16.0, -22.0, -46.0, 42.5, 22.0, 22.0], 'volume_mm3': 19359, 'solid_pla_g': 24.0, 'skeleton': True}
building snow_body_spine
   {'bbox_mm': [-72.8, -20.0, -54.0, 36.3, 20.0, -40.0], 'volume_mm3': 43644, 'solid_pla_g': 54.1, 'skeleton': True}
building snow_rig_plate
   {'bbox_mm': [-72.8, -20.0, -62.0, 36.3, 20.0, -54.0], 'volume_mm3': 31196, 'solid_pla_g': 38.7, 'skeleton': True}
building snow_ref_motor_hip
   {'bbox_mm': [-26.5, -26.5, 47.5, 26.5, 26.5, 84.5], 'volume_mm3': 80498, 'solid_pla_g': 99.8, 'skeleton': True}
building snow_ref_motor_knee
   {'bbox_mm': [-26.5, -26.5, -15.0, 26.5, 26.5, 22.0], 'volume_mm3': 80498, 'solid_pla_g': 99.8, 'skeleton': True}
building snow_ref_motor_abad
   {'bbox_mm': [-73.0, -26.5, -26.5, -36.0, 26.5, 26.5], 'volume_mm3': 80498, 'solid_pla_g': 99.8, 'skeleton': True}
building snow_ref_pulley_20T_kit
   {'bbox_mm': [-6.11, -6.11, 34.0, 6.11, 6.11, 42.0], 'volume_mm3': 782, 'solid_pla_g': 1.0, 'skeleton': True}
building snow_ref_ground
   {'bbox_mm': [-200.0, -281.0, -40.0, 200.0, -277.0, 130.0], 'volume_mm3': 272000, 'solid_pla_g': 337.3, 'skeleton': True}
building snow_coupon_fit_test
   {'bbox_mm': [0.0, -0.0, 0.0, 175.0, 80.0, 15.1], 'volume_mm3': 58784, 'solid_pla_g': 72.9, 'skeleton': True}
exit 0
