Munir-Altaher/leg-day/sim/leg_snowshoe.urdf

<?xml version="1.0"?>
<!-- generated by sim/export_urdf.py from the leg_day CAD; body frame X fwd, Y up, Z outboard -->
<robot name="leg_day_snowshoe">
  <link name="base">
    <inertial>
      <origin xyz="-0.0430059 2.21005e-09 -0.0133192" rpy="0 0 0"/>
      <mass value="0.30384"/>
      <inertia ixx="2.3996e-04" ixy="9.8197e-12" ixz="1.0241e-04" iyy="4.8148e-04" iyz="1.5124e-12" izz="3.4370e-04"/>
    </inertial>
    <visual><geometry><mesh filename="meshes/base.stl"/></geometry></visual>
    <collision><geometry><mesh filename="meshes/base.stl"/></geometry></collision>
  </link>
  <link name="abad">
    <inertial>
      <origin xyz="1.04886e-05 0.00123472 0.0578423" rpy="0 0 0"/>
      <mass value="0.84615"/>
      <inertia ixx="1.5785e-03" ixy="1.0939e-08" ixz="5.8888e-07" iyy="1.5679e-03" iyz="1.8305e-05" izz="2.8333e-04"/>
    </inertial>
    <visual><geometry><mesh filename="meshes/abad.stl"/></geometry></visual>
    <collision><geometry><mesh filename="meshes/abad.stl"/></geometry></collision>
  </link>
  <link name="thigh">
    <inertial>
      <origin xyz="-3.17143e-05 -0.0632604 0.0383563" rpy="0 0 0"/>
      <mass value="0.10029"/>
      <inertia ixx="2.8795e-04" ixy="7.3602e-08" ixz="-8.9865e-10" iyy="3.4124e-05" iyz="-6.1522e-08" izz="3.1327e-04"/>
    </inertial>
    <visual><geometry><mesh filename="meshes/thigh.stl"/></geometry></visual>
    <collision><geometry><mesh filename="meshes/thigh.stl"/></geometry></collision>
  </link>
  <link name="shank">
    <inertial>
      <origin xyz="0.00323497 -0.0354382 0.0483904" rpy="0 0 0"/>
      <mass value="0.03322"/>
      <inertia ixx="6.1103e-05" ixy="3.2355e-06" ixz="-4.3864e-07" iyy="4.4908e-06" iyz="5.0254e-06" izz="6.2166e-05"/>
    </inertial>
    <visual><geometry><mesh filename="meshes/shank.stl"/></geometry></visual>
    <collision><geometry><mesh filename="meshes/shank.stl"/></geometry></collision>
  </link>
  <link name="shoe">
    <inertial>
      <origin xyz="-0.0072288 -0.00921779 0.0530965" rpy="0 0 0"/>
      <mass value="0.03328"/>
      <inertia ixx="1.0130e-05" ixy="-7.2698e-07" ixz="3.0236e-08" iyy="2.9133e-05" iyz="1.1188e-08" izz="2.2201e-05"/>
    </inertial>
    <visual><geometry><mesh filename="meshes/shoe.stl"/></geometry></visual>
    <collision><geometry><mesh filename="meshes/shoe.stl"/></geometry></collision>
  </link>
  <joint name="abad" type="revolute">
    <parent link="base"/>
    <child link="abad"/>
    <origin xyz="0 0 0" rpy="0 0 0"/>
    <axis xyz="1 0 0"/>
    <limit lower="-0.78540" upper="0.78540" effort="4.100" velocity="38.75"/>
  </joint>
  <joint name="hip" type="revolute">
    <parent link="abad"/>
    <child link="thigh"/>
    <origin xyz="0 0 0" rpy="0 0 0"/>
    <axis xyz="0 0 1"/>
    <limit lower="-1.74533" upper="1.74533" effort="4.100" velocity="38.75"/>
  </joint>
  <joint name="knee" type="revolute">
    <parent link="thigh"/>
    <child link="shank"/>
    <origin xyz="0 -0.13 0" rpy="0 0 0"/>
    <axis xyz="0 0 1"/>
    <limit lower="0.26180" upper="2.53073" effort="2.292" velocity="12.92"/>
  </joint>
  <joint name="ankle" type="revolute">
    <parent link="shank"/>
    <child link="shoe"/>
    <origin xyz="0.00173648 -0.120152 0" rpy="0 0 0"/>
    <axis xyz="0 0 1"/>
    <limit lower="-0.90757" upper="-0.19199" effort="0.000" velocity="50.00"/>
    <dynamics damping="0.002" friction="0.09"/>   <!-- friction hinge: M3 nylock on a wave washer, ~90 mN m -->
  </joint>
</robot>
